pranavs41/tar-team1-hardware/electrical/docs/datasheets.md

# Datasheets and references

Links rather than PDFs, so the repo stays small and we always get the current revision. LCSC pages link the datasheet PDF.

## Espressif
- [ESP32-S3 Hardware Design Guidelines](https://docs.espressif.com/projects/esp-hardware-design-guidelines/en/latest/esp32s3/) is the schematic checklist for everything around the chip
- [ESP32-S3-MINI-1/1U datasheet](https://documentation.espressif.com/esp32-s3-mini-1_mini-1u_datasheet_en.pdf) has Figure 8-2 (p. 40) is the reference schematic we follow for the bare chip, crystal and RF

## Parts (LCSC)
| Part | Link |
|---|---|
| ESP32-S3FN8 | https://www.lcsc.com/product-detail/C2913196.html |
| 40 MHz crystal Q22FA12800101 | https://www.lcsc.com/product-detail/C255898.html |
| ICM-42688-P | https://www.lcsc.com/product-detail/C1850418.html |
| BMP581 | https://www.lcsc.com/product-detail/C5362283.html |
| MAX-M10S | https://www.lcsc.com/product-detail/C4153167.html |
| AP63205WU-7 | https://www.lcsc.com/product-detail/C2071056.html |
| TLV75733PDBVR | https://www.lcsc.com/product-detail/C485517.html |
| TPS7A2033PDBVR | https://www.lcsc.com/product-detail/C2862740.html |
| USBLC6-2SC6 | https://www.lcsc.com/product-detail/C7519.html |
| USB-C 16-pin | https://www.lcsc.com/product-detail/C2765186.html |
| LQG15HS2N0B02D (2.0 nH) | https://www.lcsc.com/product-detail/C2986275.html |

## Still to add
- u-blox MAX-M10S Integration Manual (RF input section)
