pranavs41/tar-team1-hardware/cad/board-bottom.png

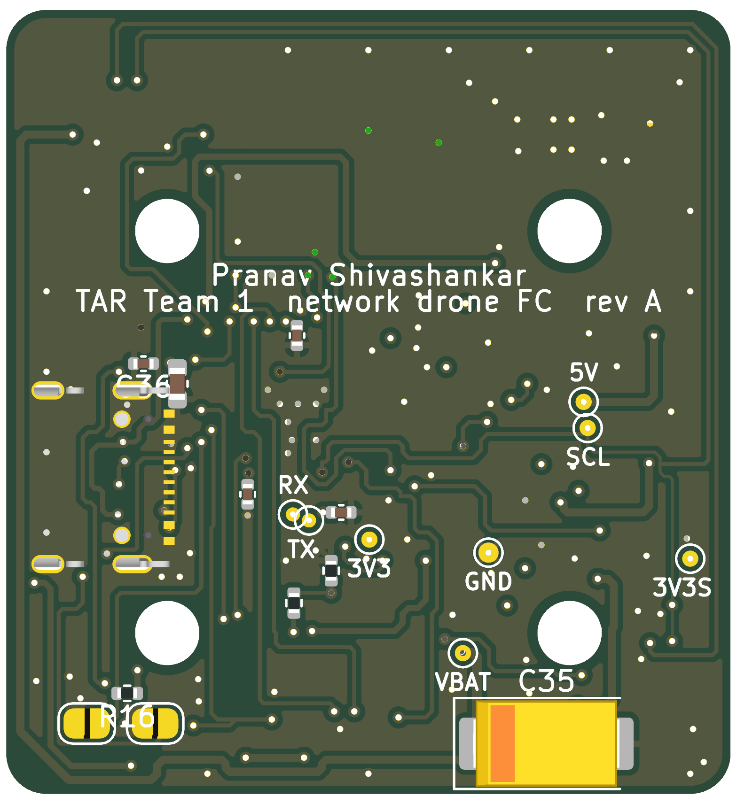
cad/board-bottom.png
