pranavs41/tar-team1-hardware/electrical/pcb/network-drone-fc/placement-top.png

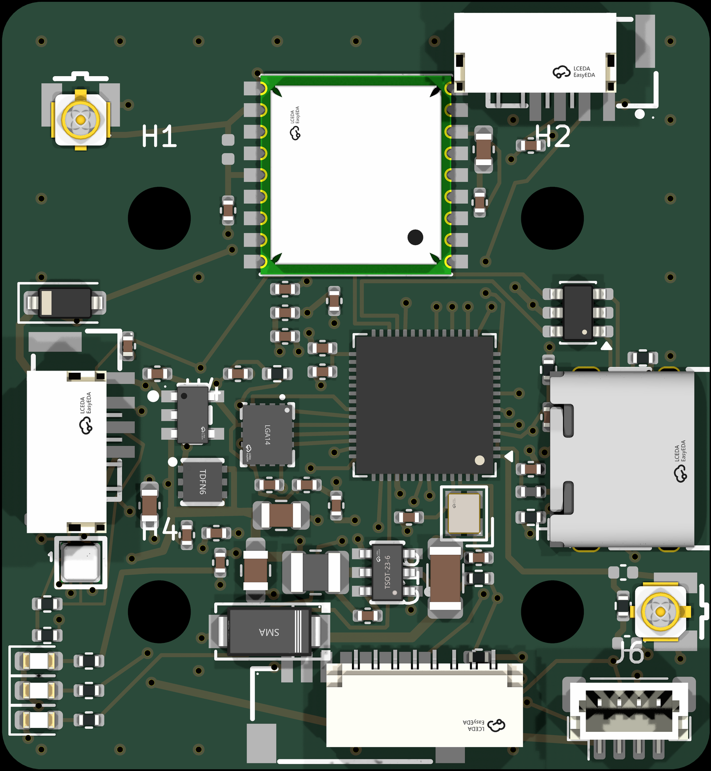
electrical/pcb/network-drone-fc/placement-top.png
