pranavs41/tar-team1-hardware/docs/full-order-sheet.csv

Group | Seller | Qty | Part | What it is | Link | Each USD | Line total USD | Note
Flight controller parts (1 board) | DigiKey | 1 | ESP32-S3FN8 | ESP32-S3 processor | https://www.digikey.com/en/products/detail/espressif-systems/ESP32-S3FN8/15822446 | 4.17 | 4.17
Flight controller parts (1 board) | DigiKey | 1 | MAX-M10S-00B | GPS module | https://www.digikey.com/en/products/detail/u-blox/MAX-M10S-00B/15712906 | 11.42 | 11.42
Flight controller parts (1 board) | Newark | 1 | ICM-42688-P | Gyro and accelerometer | https://www.newark.com/invensense/icm-42688-p/mems-module-x-y-z-1-71v/dp/77AH4524 | 4.86 | 4.86 | Buy from Newark. DigiKey has none. Take the price from Newark's page
Flight controller parts (1 board) | DigiKey | 1 | BMP581 | Barometer | https://www.digikey.com/en/products/detail/bosch-sensortec/BMP581/16036134 | 3.35 | 3.35 | Out of stock everywhere on 2026-10-13. DigiKey restock due 2026-11-04. Backorder it there or wait
Flight controller parts (1 board) | Mouser | 1 | AP63205WU-7 | 5 V buck regulator | https://www.mouser.com/ProductDetail/Diodes-Incorporated/AP63205WU-7 | 0.89 | 0.89 | Buy from Mouser, DigiKey has none. Take the price from Mouser's page
Flight controller parts (1 board) | DigiKey | 1 | TLV75733PDRVR | 3.3 V regulator, 1 A | https://www.digikey.com/en/products/detail/texas-instruments/TLV75733PDRVR/8038260 | 0.48 | 0.48
Flight controller parts (1 board) | Texas Instruments | 1 | TPS7A2033PDBVR | 3.3 V low-noise regulator | https://www.ti.com/product/TPS7A20/part-details/TPS7A2033PDBVR | 0.35 | 0.35 | Buy direct from ti.com. Not the TPS7A0233, which is a different, noisier part
Flight controller parts (1 board) | DigiKey | 1 | USBLC6-2SC6 | USB protection | https://www.digikey.com/en/products/detail/stmicroelectronics/USBLC6-2SC6/1040559 | 0.54 | 0.54
Flight controller parts (1 board) | DigiKey | 1 | FA-128 40.0000MF10Z-K3 | 40 MHz crystal, 10 pF, ±10 ppm | https://www.digikey.com/en/products/detail/epson/FA-128-40-0000MF10Z-K3/2514630 | 1.11 | 1.11
Flight controller parts (1 board) | DigiKey | 1 | TCJD107M025R0055 | 100 µF 25 V polymer capacitor | https://www.digikey.com/en/products/detail/avx-corporation/TCJD107M025R0055/4990375 | 3.65 | 3.65
Flight controller parts (1 board) | DigiKey | 1 | SMAJ12A | Battery surge diode, 12 V standoff | https://www.digikey.com/en/products/result?keywords=SMAJ12A | 0.51 | 0.51 | Was SMAJ18A: its surge clamp (up to 29 V) exceeded the 25 V capacitors and 20 V inductor on the battery line. The board is 2S only
Flight controller parts (1 board) | DigiKey | 1 | 1N5819HW-7-F | Schottky diode, 1 A 40 V, SOD-123 | https://www.digikey.com/en/products/detail/diodes-incorporated/1N5819HW-7-F/814970 | 0.31 | 0.31
Flight controller parts (1 board) | DigiKey | 3 | 150060RS75000 | LED 0603, red | https://www.digikey.com/en/products/result?keywords=150060RS75000 | 0.15 | 0.45
Flight controller parts (1 board) | DigiKey | 3 | 150060VS75000 | LED 0603, yellow-green | https://www.digikey.com/en/products/result?keywords=150060VS75000 | 0.15 | 0.45
Flight controller parts (1 board) | DigiKey | 3 | 150060YS75000 | LED 0603, yellow | https://www.digikey.com/en/products/result?keywords=150060YS75000 | 0.15 | 0.45
Flight controller parts (1 board) | DigiKey | 1 | SM08B-SRSS-TB | ESC connector, JST-SH 8-pin | https://www.digikey.com/en/products/detail/jst-sales-america-inc/SM08B-SRSS-TB-LF-SN/926714 | 0.85 | 0.85 | DigiKey lists it as SM08B-SRSS-TB(LF)(SN)
Flight controller parts (1 board) | LCSC | 1 | SM04B-GHS-TB | Obstacle sensor port, JST-GH 4-pin | https://www.lcsc.com/product-detail/Wire-To-Board-Connector_JST-SM04B-GHS-TB-LF-SN_C189895.html | 0.39 | 0.39 | LCSC ships from China. Or wait for DigiKey, restock due 2026-11-16
Flight controller parts (1 board) | DigiKey | 1 | SM07B-SRSS-TB | Charging port, JST-SH 7-pin | https://www.digikey.com/en/products/result?keywords=SM07B-SRSS-TB | 0.80 | 0.80 | DigiKey lists it as SM07B-SRSS-TB(LF)(SN)
Flight controller parts (1 board) | DigiKey | 2 | BM04B-SRSS-TB | Radio port and landing sensor port, JST-SH 4-pin top entry | https://www.digikey.com/en/products/detail/jst-sales-america-inc/BM04B-SRSS-TB/926696 | 0.53 | 1.06 | DigiKey lists it as BM04B-SRSS-TB(LF)(SN)
Flight controller parts (1 board) | DigiKey | 2 | U.FL-R-SMT-1(10) | Antenna sockets, U.FL | https://www.digikey.com/en/products/detail/hirose-electric-co-ltd/U-FL-R-SMT-1-10/2391570 | 1.67 | 3.34
Flight controller parts (1 board) | DigiKey | 1 | USB4105-GF-A | USB-C socket, 16-pin | https://www.digikey.com/en/products/detail/gct/USB4105-GF-A/11198441 | 0.80 | 0.80
Flight controller parts (1 board) | DigiKey | 1 | CIGW252010EH4R7MNE | Buck inductor, 4.7 µH, 2.2 A saturation | https://www.digikey.com/en/products/result?keywords=CIGW252010EH4R7MNE | 0.29 | 0.29
Flight controller parts (1 board) | DigiKey | 10 | LQG15HS2N0B02D | Radio supply inductor, 2.0 nH | https://www.digikey.com/en/products/result?keywords=LQG15HS2N0B02D | 0.10 | 1.00
Flight controller parts (1 board) | DigiKey | 10 | LQW15AN24NG00D | Crystal line inductor, 24 nH | https://www.digikey.com/en/products/result?keywords=LQW15AN24NG00D | 0.12 | 1.20
Flight controller parts (1 board) | DigiKey | 20 | GRM155R71C104KA88J | 0.1 µF 16 V, 0402 | https://www.digikey.com/en/products/result?keywords=GRM155R71C104KA88J | 0.10 | 2.00
Flight controller parts (1 board) | DigiKey | 10 | CL05A105KP5NNNC | 1 µF 10 V, 0402 | https://www.digikey.com/en/products/result?keywords=CL05A105KP5NNNC | 0.10 | 1.00
Flight controller parts (1 board) | DigiKey | 10 | GRM155R71H103KA88D | 10 nF 50 V, 0402 | https://www.digikey.com/en/products/result?keywords=GRM155R71H103KA88D | 0.10 | 1.00
Flight controller parts (1 board) | DigiKey | 10 | GRM1555C1H150JA01D | 15 pF 50 V, 0402 | https://www.digikey.com/en/products/result?keywords=GRM1555C1H150JA01D | 0.10 | 1.00
Flight controller parts (1 board) | DigiKey | 10 | GRM155R61C225KE11J | 2.2 µF 16 V, 0402 | https://www.digikey.com/en/products/result?keywords=GRM155R61C225KE11J | 0.22 | 2.20
Flight controller parts (1 board) | DigiKey | 10 | GRM188R60J106ME47D | 10 µF 6.3 V, 0603 | https://www.digikey.com/en/products/result?keywords=GRM188R60J106ME47D | 0.12 | 1.20
Flight controller parts (1 board) | DigiKey | 10 | GRM21BR61C226ME44L | 22 uF 16 V, 0805 | https://www.digikey.com/en/products/result?keywords=GRM21BR61C226ME44L | 0.45 | 4.50 | 16 V part keeps more of its capacitance at 5 V than the 10 V one did
Flight controller parts (1 board) | DigiKey | 1 | C2012X5R1E106K125AB | 10 µF 25 V, 0805 | https://www.digikey.com/en/products/result?keywords=C2012X5R1E106K125AB | 0.34 | 0.34 | Was the 1206 GRM319R61E106KA12D. The smaller size leaves room for the battery to reach the regulator beside it
Flight controller parts (1 board) | DigiKey | 10 | RC0402FR-0710KL | 10 kΩ 1%, 0402 | https://www.digikey.com/en/products/result?keywords=RC0402FR-0710KL | 0.10 | 1.00
Flight controller parts (1 board) | DigiKey | 10 | RC0402FR-075K1L | 5.1 kΩ 1%, 0402 | https://www.digikey.com/en/products/result?keywords=RC0402FR-075K1L | 0.10 | 1.00
Flight controller parts (1 board) | DigiKey | 10 | RC0402FR-071KL | 1 kΩ 1%, 0402 | https://www.digikey.com/en/products/result?keywords=RC0402FR-071KL | 0.10 | 1.00
Flight controller parts (1 board) | DigiKey | 10 | RC0402FR-072K2L | 2.2 kΩ 1%, 0402 | https://www.digikey.com/en/products/result?keywords=RC0402FR-072K2L | 0.10 | 1.00
Flight controller parts (1 board) | DigiKey | 10 | RC0402FR-07470RL | 470 Ω 1%, 0402 | https://www.digikey.com/en/products/detail/yageo/RC0402FR-07470RL/726619 | 0.10 | 1.00
Flight controller parts (1 board) | DigiKey | 10 | RC0402FR-07100KL | 100 kΩ 1%, 0402 | https://www.digikey.com/en/products/result?keywords=RC0402FR-07100KL | 0.10 | 1.00
Flight controller parts (1 board) | DigiKey | 10 | RC0402FR-07143KL | 143 kΩ 1%, 0402 | https://www.digikey.com/en/products/result?keywords=RC0402FR-07143KL | 0.10 | 1.00
Flight controller parts (1 board) | DigiKey | 10 | RC0402FR-0734KL | 34 kΩ 1%, 0402 | https://www.digikey.com/en/products/result?keywords=RC0402FR-0734KL | 0.10 | 1.00
Flight controller parts (1 board) | DigiKey | 10 | RC0402JR-070RL | 0 Ω link, 0402 | https://www.digikey.com/en/products/result?keywords=RC0402JR-070RL | 0.10 | 1.00
Drone parts (1 drone) | Pyrodrone | 4 | RCINPower GTS V3 1303 8000KV Plus (teal/pink) | Motor | https://pyrodrone.com/products/rcinpower-gts-v3-1303-8000kv-plus-2-3-inch-cinewhoop-micro-motor-teal-pink | 20.99 | 83.96 | Teal/pink, in stock 2026-10-15. The gold/orange colour is sold out; same motor. A fifth as a spare is worth considering
Drone parts (1 drone) | Amazon | 1 | AERO SELFIE 30 A 4-in-1 ESC | ESC, 2 to 4S, 20 mm holes, comes with its 8-pin cable | https://www.amazon.com/dp/B0DQSLQH87 | 28.90 | 28.90
Drone parts (1 drone) | Amazon | 2 | Benewake TF-Luna | Distance sensor, one forward and one down | https://www.amazon.com/dp/B0DKCSF8C5 | 25.99 | 51.98
Drone parts (1 drone) | RaceDayQuads | 1 | Gemfan Hurricane 3018, pack of 8 | Propellers, 1.5 mm hole, 4 clockwise and 4 counter-clockwise | https://www.racedayquads.com/products/gemfan-hurricane-3018-durable-bi-blade-3-prop-8-pack-1-5mm-choose-your-color | 4.99 | 4.99 | Pick a colour that shows in stock
Drone parts (1 drone) | VoCore | 1 | VoCore2 | Wi-Fi networking module | https://vocore.io/#store | 21.48 | 21.48 | Bought from the store section of the maker's front page. Ships from China. Confirm the price in the cart
Drone parts (1 drone) | DigiKey | 1 | FXP73.07.0100A | 2.4 GHz Wi-Fi antenna, U.FL plug | https://www.digikey.com/en/products/detail/taoglas-limited/FXP73-07-0100A/2332703 | 5.41 | 5.41
Drone parts (1 drone) | DigiKey | 1 | 2065600100 | GPS antenna, U.FL plug | https://www.digikey.com/en/products/result?keywords=2065600100 | 4.16 | 4.16
Drone parts (1 drone) | DigiKey | 1 | EEU-FR1V471 | 470 uF 35 V capacitor for the ESC's battery pads | https://www.digikey.com/en/products/detail/panasonic-industry/EEU-FR1V471/2433575 | 1.08 | 1.08 | Out of stock 2026-10-11, due 2026-11-09. Any 470 uF 35 V low-ESR radial capacitor works
Drone parts (1 drone) | DigiKey | 1 | GHR-04V-S | Plug housing for the forward sensor cable, JST-GH 4-pin | https://www.digikey.com/en/products/detail/jst-sales-america-inc/GHR-04V-S/807816 | 0.20 | 0.20 | Price approximate
Drone parts (1 drone) | DigiKey | 2 | AGHGH28K152 | Pre-crimped JST-GH wire, 150 mm | https://www.digikey.com/en/products/detail/jst-sales-america-inc/AGHGH28K152/6009449 | 0.49 | 0.98 | Price approximate. If the link fails, search the part number
Drone parts (1 drone) | Adafruit | 1 | Adafruit LIS3MDL magnetometer breakout (product 4479) | Compass, 1.5 g | https://www.adafruit.com/product/4479 | 9.95 | 9.95 | Shares the I2C wires of the J5 or J8 cable. Runs from that cable's 5 V. Mount it away from the battery leads and ESC
Drone parts (1 drone) | Pololu | 2 | Pololu 5521 | JST-SH 4-pin cable, bare wires on one end, 30 cm | https://www.pololu.com/product/5521 | 2.04 | 4.08 | One for the downward sensor, one for the VoCore2
Drone parts (1 drone) | Amazon | 1 | M2 nylon standoff, screw and nut kit, 180 pieces (HVAZI or similar) | Hardware for the flight controller and ESC stack | https://www.amazon.com/s?k=HVAZI+M2+nylon+standoff+screw+nut+kit+180 | 9.99 | 9.99 | M2, not M3: an M3 nut would not sit flat on top of the board at three holes. M2 passes through the M3 holes. Link is a search; pick a black M2 nylon kit with standoffs, screws and nuts. One kit covers several drones
Drone parts (1 drone) | RaceDayQuads | 1 | XT30 connector | Battery connector, male | https://www.racedayquads.com/products/xt30-connector-male-or-female | 0.99 | 0.99 | Male, for the ESC's battery lead. The battery comes with its own XT30
Drone parts (1 drone) | Amazon | 1 | OVONIC 2S 1100 mAh 7.6 V 60C battery, pack of 2 | Battery | https://www.amazon.com/dp/B0D318NL5W | 26.99 | 26.99 | Pack of 2, $13.50 a battery. High-voltage type (charge to 4.35 V a cell), XT30 plug, 60C. Price read 2026-10-15
Charging board parts (1 board) | DigiKey | 1 | BQ25887RGER | 2S boost charger with cell balancing, 4 x 4 mm QFN | https://www.digikey.com/en/products/result?keywords=BQ25887RGER | 5.61 | 5.61 | Texas Instruments. DigiKey had about 11 thousand on 2026-10-15; TI's own store was out
Charging board parts (1 board) | DigiKey | 1 | TPS259474LRPWR | eFuse with overvoltage cut-off and reverse blocking, 2.7 to 23 V, 2 x 2 mm QFN | https://www.digikey.com/en/products/result?keywords=TPS259474LRPWR | 1.95 | 1.95 | Texas Instruments. Replaces the LM73100, out of stock until December. Same footprint and same pins 1 to 8. Rated to 28 V, survives -15 V (a reversed dock), blocks the battery from the dock contacts, cuts off above the voltage set by its two resistors. Pin 9 needs a current limit resistor
Charging board parts (1 board) | DigiKey | 10 | RC0603FR-07470KL | 470 kohm 1% resistor, 0603 (enable pull-up) | https://www.digikey.com/en/products/result?keywords=RC0603FR-07470KL | 0.03 | 0.30 | Yageo. From IN to EN/UVLO. The datasheet asks for at least 350 kohm above 5 V or where the input can be reversed
Charging board parts (1 board) | DigiKey | 10 | RC0603FR-07402KL | 402 kohm 1% resistor, 0603 (overvoltage cut-off, top) | https://www.digikey.com/en/products/result?keywords=RC0603FR-07402KL | 0.03 | 0.30 | Yageo. With 100 kohm below it, cuts the charger off above about 6.0 V. Ten times the old 40.2 kohm so a reversed dock pulls little current out of the pin
Charging board parts (1 board) | DigiKey | 10 | RMCF0603FT100K | 100 kohm 1% resistor, 0603 (overvoltage cut-off, bottom) | https://www.digikey.com/en/products/result?keywords=RMCF0603FT100K | 0.02 | 0.20 | Stackpole. The Yageo and Panasonic 100 kohm are out of stock
Charging board parts (1 board) | DigiKey | 1 | DFE252012F-1R0M=P2 | Power inductor 1 uH, shielded | https://www.digikey.com/en/products/result?keywords=DFE252012F-1R0M%3DP2 | 0.25 | 0.25 | Murata. Saturation 4.7 A. The inductor TI's datasheet uses. Peak current here is about 1.6 A (0.925 A input plus half of a 1.35 A ripple)
Charging board parts (1 board) | DigiKey | 1 | SMBJ5.0A | 5 V surge diode on the dock input | https://www.digikey.com/en/products/detail/littelfuse-inc/SMBJ5-0A/285950 | 0.50 | 0.50 | Littelfuse. The Diodes Incorporated SMBJ5.0A-13-F is out of stock until January; same ratings. Clamps near 9 V, which the eFuse (28 V) and the charger's input (20 V) both survive
Charging board parts (1 board) | DigiKey | 1 | 1206L110THYR | Resettable fuse, about 1 A hold, 1206 | https://www.digikey.com/en/products/result?keywords=1206L110THYR | 0.65 | 0.65 | Littelfuse. Checked 2026-10-15: 1.1 A hold, 2.2 A trip, 8 V max
Charging board parts (1 board) | DigiKey | 10 | RC0603FR-071K2L | 1.2 kohm 1% resistor, 0603 (input current limit) | https://www.digikey.com/en/products/result?keywords=RC0603FR-071K2L | 0.10 | 1.00 | Yageo. Input limit = 1110 / 1200 ohm = 0.925 A typical (datasheet K_ILIM 1110)
Charging board parts (1 board) | DigiKey | 10 | ERJ-3EKF2211V | 2.21 kohm 1% resistor, 0603 (eFuse current limit) | https://www.digikey.com/en/products/result?keywords=ERJ-3EKF2211V | 0.04 | 0.40 | Panasonic. From the eFuse's ILM pin (9) to GND. Trips at 3334 / 2210 = about 1.5 A, above the charger's 0.925 A input limit. Must not be left open or shorted to GND
Charging board parts (1 board) | DigiKey | 10 | RC0603FR-07300RL | 300 ohm 1% resistor, 0603 (cell balancing midpoint) | https://www.digikey.com/en/products/result?keywords=RC0603FR-07300RL | 0.10 | 1.00 | Yageo. 0603 assumed
Charging board parts (1 board) | DigiKey | 10 | RC0603FR-075K23L | 5.23 kohm 1% resistor, 0603 (thermistor bias, top) | https://www.digikey.com/en/products/result?keywords=RC0603FR-075K23L | 0.10 | 1.00 | Yageo. Datasheet value for a 103AT thermistor is 5.24 kohm; 5.23 kohm is the nearest 1% value
Charging board parts (1 board) | DigiKey | 10 | RC0603FR-0730K1L | 30.1 kohm 1% resistor, 0603 (thermistor bias, bottom) | https://www.digikey.com/en/products/result?keywords=RC0603FR-0730K1L | 0.10 | 1.00 | Yageo. Datasheet value is 30.31 kohm; 30.1 kohm is the nearest 1% value
Charging board parts (1 board) | DigiKey | 2 | RC2512FK-0740R2L | 40.2 ohm 1% resistor, 1 W, 2512 (balancing current set) | https://www.digikey.com/en/products/result?keywords=RC2512FK-0740R2L | 0.32 | 0.64 | Yageo. Every 41.2 ohm 1 W 2512 is out of stock. Sets about 104 mA of balancing current (4.2 V / 40.2 ohm) and dissipates about 0.44 W, inside the 1 W rating
Charging board parts (1 board) | DigiKey | 1 | 103AT-2 | 10 kohm battery thermistor | https://www.digikey.com/en/products/result?keywords=103AT-2 | 0.68 | 0.68 | Semitec. Must touch the battery
Charging board parts (1 board) | DigiKey | 10 | C1608X7R1E105K080AB | 1 uF 25 V X7R capacitor, 0603 (VBUS) | https://www.digikey.com/en/products/result?keywords=C1608X7R1E105K080AB | 0.11 | 1.10 | TDK. The Murata GRM188R71E105KA12D is obsolete. Datasheet: at least 1 uF at VBUS, 25 V rating preferred for a 5 V input
Charging board parts (1 board) | DigiKey | 10 | C2012X5R1E106K125AB | 10 uF 25 V capacitor, 0805 (PMID and BAT) | https://www.digikey.com/en/products/result?keywords=C2012X5R1E106K125AB | 0.34 | 3.40 | TDK, X5R. Was the Murata GRM21BR61E106KA73L, out of stock until November; this is the same part as the flight controller's C16. Datasheet: 10 uF at PMID with a 25 V rating; the same part works at BAT
Charging board parts (1 board) | DigiKey | 10 | C0603C473K5RACTU | 47 nF 50 V X7R capacitor, 0603 (bootstrap) | https://www.digikey.com/en/products/result?keywords=C0603C473K5RACTU | 0.07 | 0.70 | KEMET. The Murata GRM188R71H473KA61D is obsolete
Charging board parts (1 board) | DigiKey | 10 | C1608X5R1C475K080AC | 4.7 uF 16 V X5R capacitor, 0603 (REGN) | https://www.digikey.com/en/products/result?keywords=C1608X5R1C475K080AC | 0.15 | 1.50 | TDK. DigiKey does not stock the Murata GRM188R61C475KAAJD
Charging board parts (1 board) | DigiKey | 4 | C2012X5R1C226M085AC | 22 uF 16 V X5R capacitor, 0805 (output) | https://www.digikey.com/en/products/result?keywords=C2012X5R1C226M085AC | 0.63 | 2.52 | TDK, 0.85 mm thick. The Murata GRM21BR61C226ME44L is out of stock until February. Datasheet: at least 44 uF at SNS, 16 V or more, so two per board; check the derated value at 8.4 V
Charging board parts (1 board) | DigiKey | 1 | SM07B-SRSS-TB | 7-pin JST-SH connector to the flight controller | https://www.digikey.com/en/products/result?keywords=SM07B-SRSS-TB | 0.80 | 0.80 | JST. Same part as J7 on the flight controller
Charging board parts (1 board) | DigiKey | 1 | B3B-XH-A | 3-pin JST-XH header for the battery's balance plug | https://www.digikey.com/en/products/result?keywords=B3B-XH-A | 0.15 | 0.15 | JST
Charging board parts (1 board) | DigiKey | 2 | SHR-07V-S-B | 7-pin JST-SH plug housing, both ends of the cable to the flight controller | https://www.digikey.com/en/products/detail/jst-sales-america-inc/SHR-07V-S-B/759871 | 0.15 | 0.30 | JST
Charging board parts (1 board) | DigiKey | 7 | ASSHSSH28K152 | Pre-crimped JST-SH wire, 150 mm, one per cable pin | https://www.digikey.com/en/products/detail/jst-sales-america-inc/ASSHSSH28K152/6009452 | 0.46 | 3.22 | JST. Push one end of each wire into each housing, pin 1 to pin 1
 |  |  |  | Drone parts |  |  | 255.14
 |  |  |  | Flight controller parts |  |  | 64.96
 |  |  |  | Charging board parts |  |  | 29.17
 |  |  |  | Total before shipping and tax |  |  | 349.27
