pranavs41/tar-team1-hardware/docs/vendor-orders/adafruit.xlsx

Item | Quantity | Cost per Item | Total Cost | Item/SKU Number | Other Specs if Applicable | Link | Total
Adafruit LIS3MDL magnetometer breakout (product 4479) | 1 | $9.95 |  | Adafruit LIS3MDL magnetometer breakout (product 4479) | Drone; Compass, 1.5 g; Shares the I2C wires of the J5 or J8 cable. Runs from that cable's 5 V. | https://www.adafruit.com/product/4479
 |  |  |  |  |  | Please select fastest shipping available | $0.00
 |  |  |  |  |  | Grand Total
