pranavs41/tar-team1-hardware/docs/vendor-orders/all-vendors.xlsx

Sheet: DigiKey
Item | Quantity | Cost per Item | Total Cost | Item/SKU Number | Other Specs if Applicable | Link | Total
ESP32-S3 processor | 1 | $4.17 |  | ESP32-S3FN8 | Flight controller | https://www.digikey.com/en/products/detail/espressif-systems/ESP32-S3FN8/15822446
GPS module | 1 | $11.42 |  | MAX-M10S-00B | Flight controller | https://www.digikey.com/en/products/detail/u-blox/MAX-M10S-00B/15712906
Barometer | 1 | $3.35 |  | BMP581 | Flight controller; Out of stock everywhere on 2026-10-13. DigiKey restock due 2026-11-04. | https://www.digikey.com/en/products/detail/bosch-sensortec/BMP581/16036134
3.3 V regulator, 1 A | 1 | $0.48 |  | TLV75733PDRVR | Flight controller | https://www.digikey.com/en/products/detail/texas-instruments/TLV75733PDRVR/8038260
USB protection | 1 | $0.54 |  | USBLC6-2SC6 | Flight controller | https://www.digikey.com/en/products/detail/stmicroelectronics/USBLC6-2SC6/1040559
40 MHz crystal, 10 pF, ±10 ppm | 1 | $1.11 |  | FA-128 40.0000MF10Z-K3 | Flight controller | https://www.digikey.com/en/products/detail/epson/FA-128-40-0000MF10Z-K3/2514630
100 µF 25 V polymer capacitor | 1 | $3.65 |  | TCJD107M025R0055 | Flight controller | https://www.digikey.com/en/products/detail/avx-corporation/TCJD107M025R0055/4990375
Battery surge diode, 12 V standoff | 1 | $0.51 |  | SMAJ12A | Flight controller; The board is 2S only | https://www.digikey.com/en/products/result?keywords=SMAJ12A
Schottky diode, 1 A 40 V, SOD-123 | 1 | $0.31 |  | 1N5819HW-7-F | Flight controller | https://www.digikey.com/en/products/detail/diodes-incorporated/1N5819HW-7-F/814970
LED 0603, red | 3 | $0.15 |  | 150060RS75000 | Flight controller | https://www.digikey.com/en/products/result?keywords=150060RS75000
LED 0603, yellow-green | 3 | $0.15 |  | 150060VS75000 | Flight controller | https://www.digikey.com/en/products/result?keywords=150060VS75000
LED 0603, yellow | 3 | $0.15 |  | 150060YS75000 | Flight controller | https://www.digikey.com/en/products/result?keywords=150060YS75000
ESC connector, JST-SH 8-pin | 1 | $0.85 |  | SM08B-SRSS-TB | Flight controller; DigiKey lists it as SM08B-SRSS-TB(LF)(SN) | https://www.digikey.com/en/products/detail/jst-sales-america-inc/SM08B-SRSS-TB-LF-SN/926714
Charging port, JST-SH 7-pin | 1 | $0.80 |  | SM07B-SRSS-TB | Flight controller; DigiKey lists it as SM07B-SRSS-TB(LF)(SN) | https://www.digikey.com/en/products/result?keywords=SM07B-SRSS-TB
Radio port and landing sensor port, JST-SH 4-pin top entry | 2 | $0.53 |  | BM04B-SRSS-TB | Flight controller; DigiKey lists it as BM04B-SRSS-TB(LF)(SN) | https://www.digikey.com/en/products/detail/jst-sales-america-inc/BM04B-SRSS-TB/926696
Antenna sockets, U.FL | 2 | $1.67 |  | U.FL-R-SMT-1(10) | Flight controller | https://www.digikey.com/en/products/detail/hirose-electric-co-ltd/U-FL-R-SMT-1-10/2391570
USB-C socket, 16-pin | 1 | $0.80 |  | USB4105-GF-A | Flight controller | https://www.digikey.com/en/products/detail/gct/USB4105-GF-A/11198441
Buck inductor, 4.7 µH, 2.2 A saturation | 1 | $0.29 |  | CIGW252010EH4R7MNE | Flight controller | https://www.digikey.com/en/products/result?keywords=CIGW252010EH4R7MNE
Radio supply inductor, 2.0 nH | 10 | $0.10 |  | LQG15HS2N0B02D | Flight controller | https://www.digikey.com/en/products/result?keywords=LQG15HS2N0B02D
Crystal line inductor, 24 nH | 10 | $0.12 |  | LQW15AN24NG00D | Flight controller | https://www.digikey.com/en/products/result?keywords=LQW15AN24NG00D
0.1 µF 16 V, 0402 | 20 | $0.10 |  | GRM155R71C104KA88J | Flight controller | https://www.digikey.com/en/products/result?keywords=GRM155R71C104KA88J
1 µF 10 V, 0402 | 10 | $0.10 |  | CL05A105KP5NNNC | Flight controller | https://www.digikey.com/en/products/result?keywords=CL05A105KP5NNNC
10 nF 50 V, 0402 | 10 | $0.10 |  | GRM155R71H103KA88D | Flight controller | https://www.digikey.com/en/products/result?keywords=GRM155R71H103KA88D
15 pF 50 V, 0402 | 10 | $0.10 |  | GRM1555C1H150JA01D | Flight controller | https://www.digikey.com/en/products/result?keywords=GRM1555C1H150JA01D
2.2 µF 16 V, 0402 | 10 | $0.22 |  | GRM155R61C225KE11J | Flight controller | https://www.digikey.com/en/products/result?keywords=GRM155R61C225KE11J
10 µF 6.3 V, 0603 | 10 | $0.12 |  | GRM188R60J106ME47D | Flight controller | https://www.digikey.com/en/products/result?keywords=GRM188R60J106ME47D
22 uF 16 V, 0805 | 10 | $0.45 |  | GRM21BR61C226ME44L | Flight controller; 16 V part keeps more of its capacitance at 5 V than the 10 V one did | https://www.digikey.com/en/products/result?keywords=GRM21BR61C226ME44L
10 µF 25 V, 0805 | 1 | $0.34 |  | C2012X5R1E106K125AB | Flight controller; The smaller size leaves room for the battery to reach the regulator beside it | https://www.digikey.com/en/products/result?keywords=C2012X5R1E106K125AB
10 kΩ 1%, 0402 | 10 | $0.10 |  | RC0402FR-0710KL | Flight controller | https://www.digikey.com/en/products/result?keywords=RC0402FR-0710KL
5.1 kΩ 1%, 0402 | 10 | $0.10 |  | RC0402FR-075K1L | Flight controller | https://www.digikey.com/en/products/result?keywords=RC0402FR-075K1L
1 kΩ 1%, 0402 | 10 | $0.10 |  | RC0402FR-071KL | Flight controller | https://www.digikey.com/en/products/result?keywords=RC0402FR-071KL
2.2 kΩ 1%, 0402 | 10 | $0.10 |  | RC0402FR-072K2L | Flight controller | https://www.digikey.com/en/products/result?keywords=RC0402FR-072K2L
470 Ω 1%, 0402 | 10 | $0.10 |  | RC0402FR-07470RL | Flight controller | https://www.digikey.com/en/products/detail/yageo/RC0402FR-07470RL/726619
100 kΩ 1%, 0402 | 10 | $0.10 |  | RC0402FR-07100KL | Flight controller | https://www.digikey.com/en/products/result?keywords=RC0402FR-07100KL
143 kΩ 1%, 0402 | 10 | $0.10 |  | RC0402FR-07143KL | Flight controller | https://www.digikey.com/en/products/result?keywords=RC0402FR-07143KL
34 kΩ 1%, 0402 | 10 | $0.10 |  | RC0402FR-0734KL | Flight controller | https://www.digikey.com/en/products/result?keywords=RC0402FR-0734KL
0 Ω link, 0402 | 10 | $0.10 |  | RC0402JR-070RL | Flight controller | https://www.digikey.com/en/products/result?keywords=RC0402JR-070RL
FXP73.07.0100A | 1 | $5.41 |  | FXP73.07.0100A | Drone; 2.4 GHz Wi-Fi antenna, U.FL plug | https://www.digikey.com/en/products/detail/taoglas-limited/FXP73-07-0100A/2332703
2065600100 | 1 | $4.16 |  | 2065600100 | Drone; GPS antenna, U.FL plug | https://www.digikey.com/en/products/result?keywords=2065600100
EEU-FR1V471 | 1 | $1.08 |  | EEU-FR1V471 | Drone; 470 uF 35 V capacitor for the ESC's battery pads; Out of stock 2026-10-11, due 2026-11-09. Any 470 uF 35 V low-ESR radial capacitor works | https://www.digikey.com/en/products/detail/panasonic-industry/EEU-FR1V471/2433575
GHR-04V-S | 1 | $0.20 |  | GHR-04V-S | Drone; Plug housing for the forward sensor cable, JST-GH 4-pin; Price approximate | https://www.digikey.com/en/products/detail/jst-sales-america-inc/GHR-04V-S/807816
AGHGH28K152 | 2 | $0.49 |  | AGHGH28K152 | Drone; Pre-crimped JST-GH wire, 150 mm; Price approximate. If the link fails, search the part number | https://www.digikey.com/en/products/detail/jst-sales-america-inc/AGHGH28K152/6009449
2S boost charger with cell balancing, 4 x 4 mm QFN | 1 | $5.61 |  | BQ25887RGER | Charging board; Texas Instruments. DigiKey had about 11 thousand on 2026-10-15; TI's own store was out | https://www.digikey.com/en/products/result?keywords=BQ25887RGER
eFuse with overvoltage cut-off and reverse blocking, 2.7 to 23 V, 2 x 2 mm QFN | 1 | $1.95 |  | TPS259474LRPWR | Charging board; Texas Instruments. Replaces the LM73100, out of stock until December. | https://www.digikey.com/en/products/result?keywords=TPS259474LRPWR
470 kohm 1% resistor, 0603 (enable pull-up) | 10 | $0.03 |  | RC0603FR-07470KL | Charging board; Yageo. From IN to EN/UVLO. | https://www.digikey.com/en/products/result?keywords=RC0603FR-07470KL
402 kohm 1% resistor, 0603 (overvoltage cut-off, top) | 10 | $0.03 |  | RC0603FR-07402KL | Charging board; Yageo. With 100 kohm below it, cuts the charger off above about 6.0 V. | https://www.digikey.com/en/products/result?keywords=RC0603FR-07402KL
100 kohm 1% resistor, 0603 (overvoltage cut-off, bottom) | 10 | $0.02 |  | RMCF0603FT100K | Charging board; Stackpole. The Yageo and Panasonic 100 kohm are out of stock | https://www.digikey.com/en/products/result?keywords=RMCF0603FT100K
Power inductor 1 uH, shielded | 1 | $0.25 |  | DFE252012F-1R0M=P2 | Charging board; Murata. Saturation 4.7 A. | https://www.digikey.com/en/products/result?keywords=DFE252012F-1R0M%3DP2
5 V surge diode on the dock input | 1 | $0.50 |  | SMBJ5.0A | Charging board; Littelfuse. The Diodes Incorporated SMBJ5.0A-13-F is out of stock until January; same ratings. | https://www.digikey.com/en/products/detail/littelfuse-inc/SMBJ5-0A/285950
Resettable fuse, about 1 A hold, 1206 | 1 | $0.65 |  | 1206L110THYR | Charging board; Littelfuse. Checked 2026-10-15: 1.1 A hold, 2.2 A trip, 8 V max | https://www.digikey.com/en/products/result?keywords=1206L110THYR
1.2 kohm 1% resistor, 0603 (input current limit) | 10 | $0.10 |  | RC0603FR-071K2L | Charging board; Yageo. Input limit = 1110 / 1200 ohm = 0.925 A typical (datasheet K_ILIM 1110) | https://www.digikey.com/en/products/result?keywords=RC0603FR-071K2L
2.21 kohm 1% resistor, 0603 (eFuse current limit) | 10 | $0.04 |  | ERJ-3EKF2211V | Charging board; Panasonic. From the eFuse's ILM pin (9) to GND. | https://www.digikey.com/en/products/result?keywords=ERJ-3EKF2211V
300 ohm 1% resistor, 0603 (cell balancing midpoint) | 10 | $0.10 |  | RC0603FR-07300RL | Charging board; Yageo. 0603 assumed | https://www.digikey.com/en/products/result?keywords=RC0603FR-07300RL
5.23 kohm 1% resistor, 0603 (thermistor bias, top) | 10 | $0.10 |  | RC0603FR-075K23L | Charging board; Yageo. Datasheet value for a 103AT thermistor is 5.24 kohm; 5.23 kohm is the nearest 1% value | https://www.digikey.com/en/products/result?keywords=RC0603FR-075K23L
30.1 kohm 1% resistor, 0603 (thermistor bias, bottom) | 10 | $0.10 |  | RC0603FR-0730K1L | Charging board; Yageo. Datasheet value is 30.31 kohm; 30.1 kohm is the nearest 1% value | https://www.digikey.com/en/products/result?keywords=RC0603FR-0730K1L
40.2 ohm 1% resistor, 1 W, 2512 (balancing current set) | 2 | $0.32 |  | RC2512FK-0740R2L | Charging board; Yageo. Every 41.2 ohm 1 W 2512 is out of stock. | https://www.digikey.com/en/products/result?keywords=RC2512FK-0740R2L
10 kohm battery thermistor | 1 | $0.68 |  | 103AT-2 | Charging board; Semitec. Must touch the battery | https://www.digikey.com/en/products/result?keywords=103AT-2
1 uF 25 V X7R capacitor, 0603 (VBUS) | 10 | $0.11 |  | C1608X7R1E105K080AB | Charging board; TDK. The Murata GRM188R71E105KA12D is obsolete. | https://www.digikey.com/en/products/result?keywords=C1608X7R1E105K080AB
10 uF 25 V capacitor, 0805 (PMID and BAT) | 10 | $0.34 |  | C2012X5R1E106K125AB | Charging board; TDK, X5R. Datasheet: 10 uF at PMID with a 25 V rating; the same part works at BAT | https://www.digikey.com/en/products/result?keywords=C2012X5R1E106K125AB
47 nF 50 V X7R capacitor, 0603 (bootstrap) | 10 | $0.07 |  | C0603C473K5RACTU | Charging board; KEMET. The Murata GRM188R71H473KA61D is obsolete | https://www.digikey.com/en/products/result?keywords=C0603C473K5RACTU
4.7 uF 16 V X5R capacitor, 0603 (REGN) | 10 | $0.15 |  | C1608X5R1C475K080AC | Charging board; TDK. DigiKey does not stock the Murata GRM188R61C475KAAJD | https://www.digikey.com/en/products/result?keywords=C1608X5R1C475K080AC
22 uF 16 V X5R capacitor, 0805 (output) | 4 | $0.63 |  | C2012X5R1C226M085AC | Charging board; TDK, 0.85 mm thick. The Murata GRM21BR61C226ME44L is out of stock until February. | https://www.digikey.com/en/products/result?keywords=C2012X5R1C226M085AC
7-pin JST-SH connector to the flight controller | 1 | $0.80 |  | SM07B-SRSS-TB | Charging board; JST. Same part as J7 on the flight controller | https://www.digikey.com/en/products/result?keywords=SM07B-SRSS-TB
3-pin JST-XH header for the battery's balance plug | 1 | $0.15 |  | B3B-XH-A | Charging board; JST | https://www.digikey.com/en/products/result?keywords=B3B-XH-A
7-pin JST-SH plug housing, both ends of the cable to the flight controller | 2 | $0.15 |  | SHR-07V-S-B | Charging board; JST | https://www.digikey.com/en/products/detail/jst-sales-america-inc/SHR-07V-S-B/759871
Pre-crimped JST-SH wire, 150 mm, one per cable pin | 7 | $0.46 |  | ASSHSSH28K152 | Charging board; JST. Push one end of each wire into each housing, pin 1 to pin 1 | https://www.digikey.com/en/products/detail/jst-sales-america-inc/ASSHSSH28K152/6009452
 |  |  |  |  |  | Please select fastest shipping available | $0.00
 |  |  |  |  |  | Grand Total

Sheet: Newark
Item | Quantity | Cost per Item | Total Cost | Item/SKU Number | Other Specs if Applicable | Link | Total
Gyro and accelerometer | 1 | $4.86 |  | ICM-42688-P | Flight controller; DigiKey has none. | https://www.newark.com/invensense/icm-42688-p/mems-module-x-y-z-1-71v/dp/77AH4524
 |  |  |  |  |  | Please select fastest shipping available | $0.00
 |  |  |  |  |  | Grand Total

Sheet: Mouser
Item | Quantity | Cost per Item | Total Cost | Item/SKU Number | Other Specs if Applicable | Link | Total
5 V buck regulator | 1 | $0.89 |  | AP63205WU-7 | Flight controller | https://www.mouser.com/ProductDetail/Diodes-Incorporated/AP63205WU-7
 |  |  |  |  |  | Please select fastest shipping available | $0.00
 |  |  |  |  |  | Grand Total

Sheet: Texas Instruments
Item | Quantity | Cost per Item | Total Cost | Item/SKU Number | Other Specs if Applicable | Link | Total
3.3 V low-noise regulator | 1 | $0.35 |  | TPS7A2033PDBVR | Flight controller; Not the TPS7A0233, which is a different, noisier part | https://www.ti.com/product/TPS7A20/part-details/TPS7A2033PDBVR
 |  |  |  |  |  | Please select fastest shipping available | $0.00
 |  |  |  |  |  | Grand Total

Sheet: LCSC
Item | Quantity | Cost per Item | Total Cost | Item/SKU Number | Other Specs if Applicable | Link | Total
Obstacle sensor port, JST-GH 4-pin | 1 | $0.39 |  | SM04B-GHS-TB | Flight controller; LCSC ships from China. Or wait for DigiKey, restock due 2026-11-16 | https://www.lcsc.com/product-detail/Wire-To-Board-Connector_JST-SM04B-GHS-TB-LF-SN_C189895.html
 |  |  |  |  |  | Please select fastest shipping available | $0.00
 |  |  |  |  |  | Grand Total

Sheet: Pyrodrone
Item | Quantity | Cost per Item | Total Cost | Item/SKU Number | Other Specs if Applicable | Link | Total
RCINPower GTS V3 1303 8000KV Plus (teal/pink) | 4 | $20.99 |  | RCINPower GTS V3 1303 8000KV Plus (teal/pink) | Drone; Motor; Teal/pink, in stock 2026-10-15. The gold/orange colour is sold out; same motor. | https://pyrodrone.com/products/rcinpower-gts-v3-1303-8000kv-plus-2-3-inch-cinewhoop-micro-motor-teal-pink
 |  |  |  |  |  | Please select fastest shipping available | $0.00
 |  |  |  |  |  | Grand Total

Sheet: Amazon
Item | Quantity | Cost per Item | Total Cost | Item/SKU Number | Other Specs if Applicable | Link | Total
AERO SELFIE 30 A 4-in-1 ESC | 1 | $28.90 |  | B0DQSLQH87 | Drone; ESC, 2 to 4S, 20 mm holes, comes with its 8-pin cable | https://www.amazon.com/dp/B0DQSLQH87
Benewake TF-Luna | 2 | $25.99 |  | B0DKCSF8C5 | Drone; Distance sensor, one forward and one down | https://www.amazon.com/dp/B0DKCSF8C5
M2 nylon standoff, screw and nut kit, 180 pieces (HVAZI or similar) | 1 | $9.99 |  |  | Drone; Hardware for the flight controller and ESC stack; M2, not M3: an M3 nut would not sit flat on top of the board at three holes. M2 passes through the M3 holes. | https://www.amazon.com/s?k=HVAZI+M2+nylon+standoff+screw+nut+kit+180
OVONIC 2S 1100 mAh 7.6 V 60C battery, pack of 2 | 1 | $26.99 |  | B0D318NL5W | Drone; Battery; Pack of 2, $13.50 a battery. High-voltage type (charge to 4.35 V a cell), XT30 plug, 60C. | https://www.amazon.com/dp/B0D318NL5W
 |  |  |  |  |  | Please select fastest shipping available | $0.00
 |  |  |  |  |  | Grand Total

Sheet: RaceDayQuads
Item | Quantity | Cost per Item | Total Cost | Item/SKU Number | Other Specs if Applicable | Link | Total
Gemfan Hurricane 3018, pack of 8 | 1 | $4.99 |  | Gemfan Hurricane 3018, pack of 8 | Drone; Propellers, 1.5 mm hole, 4 clockwise and 4 counter-clockwise; Pick a colour that shows in stock | https://www.racedayquads.com/products/gemfan-hurricane-3018-durable-bi-blade-3-prop-8-pack-1-5mm-choose-your-color
XT30 connector | 1 | $0.99 |  | XT30 connector | Drone; Battery connector, male; Male, for the ESC's battery lead. The battery comes with its own XT30 | https://www.racedayquads.com/products/xt30-connector-male-or-female
 |  |  |  |  |  | Please select fastest shipping available | $0.00
 |  |  |  |  |  | Grand Total

Sheet: VoCore
Item | Quantity | Cost per Item | Total Cost | Item/SKU Number | Other Specs if Applicable | Link | Total
VoCore2 | 1 | $21.48 |  | VoCore2 | Drone; Wi-Fi networking module; Bought from the store section of the maker's front page. Ships from China. | https://vocore.io/#store
 |  |  |  |  |  | Please select fastest shipping available | $0.00
 |  |  |  |  |  | Grand Total

Sheet: Adafruit
Item | Quantity | Cost per Item | Total Cost | Item/SKU Number | Other Specs if Applicable | Link | Total
Adafruit LIS3MDL magnetometer breakout (product 4479) | 1 | $9.95 |  | Adafruit LIS3MDL magnetometer breakout (product 4479) | Drone; Compass, 1.5 g; Shares the I2C wires of the J5 or J8 cable. Runs from that cable's 5 V. | https://www.adafruit.com/product/4479
 |  |  |  |  |  | Please select fastest shipping available | $0.00
 |  |  |  |  |  | Grand Total

Sheet: Pololu
Item | Quantity | Cost per Item | Total Cost | Item/SKU Number | Other Specs if Applicable | Link | Total
Pololu 5521 | 2 | $2.04 |  | Pololu 5521 | Drone; JST-SH 4-pin cable, bare wires on one end, 30 cm; One for the downward sensor, one for the VoCore2 | https://www.pololu.com/product/5521
 |  |  |  |  |  | Please select fastest shipping available | $0.00
 |  |  |  |  |  | Grand Total
