pranavs41/tar-team1-hardware/tools/vendor-order-template.xlsx

Item | Quantity | Cost per Item | Total Cost | Item/SKU Number | Other Specs if Applicable | Link | Total
 |  |  |  |  |  | Please select fastest shipping available | $0.00
 |  |  |  |  |  | Grand Total
