pranavs41/tar-team1-hardware/cad/network-drone-fc.step

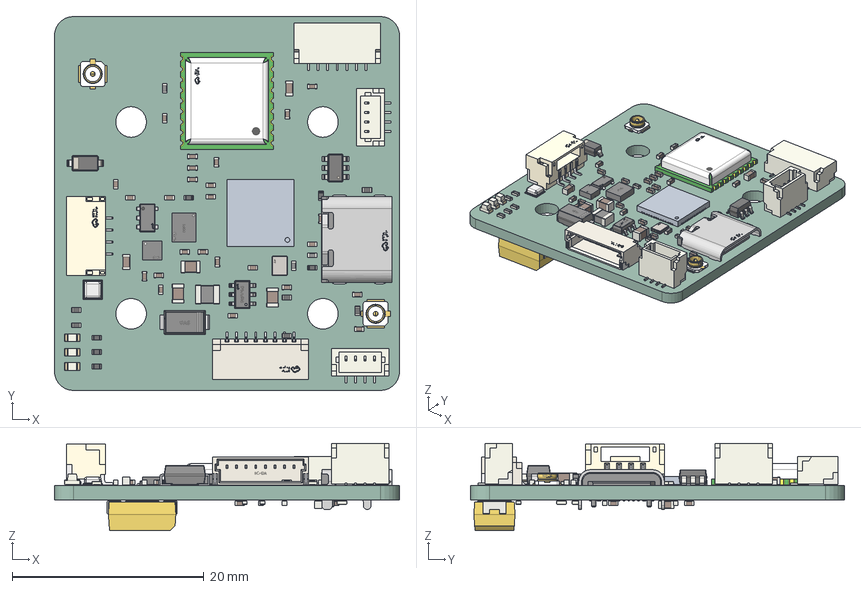
[picture p4: CAD file, 2026-10-17]
cad/network-drone-fc.step
36.0 x 39.0 x 9.10 mm
C_0402_1005Metric x 33
SMA_L4.4-W2.6-LS5.0-RD
R_0402_1005Metric x 15
LGA-10_L2.0-W2.0-P0.50-TL_BMP581
TSOT-23-6_L2.9-W1.6-H1.1-LS2.8-P0.95
SOT-23-6
LED_0603_1608Metric x 3
L_1008_2520Metric
L_0402_1005Metric x 3
C_0805_2012Metric x 3
C_0603_1608Metric x 3
JST_SH_BM04B-SRSS-TB_1x04-1MP_P1.00mm_Vertical x 2
SOT-23-5_L2.9-W1.6-P0.95-LS2.8-BR
CONN-SMD_GH1.25-WS-4P
USB-C-SMD_TYPE-C-6PIN-2MD-073
TDFN-6_L2.0-W2.0-H0.8-P0.65
D_SOD-123
network-drone-fc 1.42.1
LGA-14_L2.5-W3.0-H0.9-P0.50
CRYSTAL-SMD_4P-L2.0-W1.6-BL
JST_SH_SM07B-SRSS-TB_1x07-1MP_P1.00mm_Horizontal
RF-SMD_FRF05002-JSS103M x 2
SMD-18_L10.1-W9.7-P1.10-TL_SKG09F
CONN-SMD_SR1.00-WS-8P
CP_EIA-7343-31_Kemet-D
network-drone-fc_PCB
