pranavs41/tar-team1-hardware/pcb/network-drone-fc/production/rev-A/assembly-bottom.png

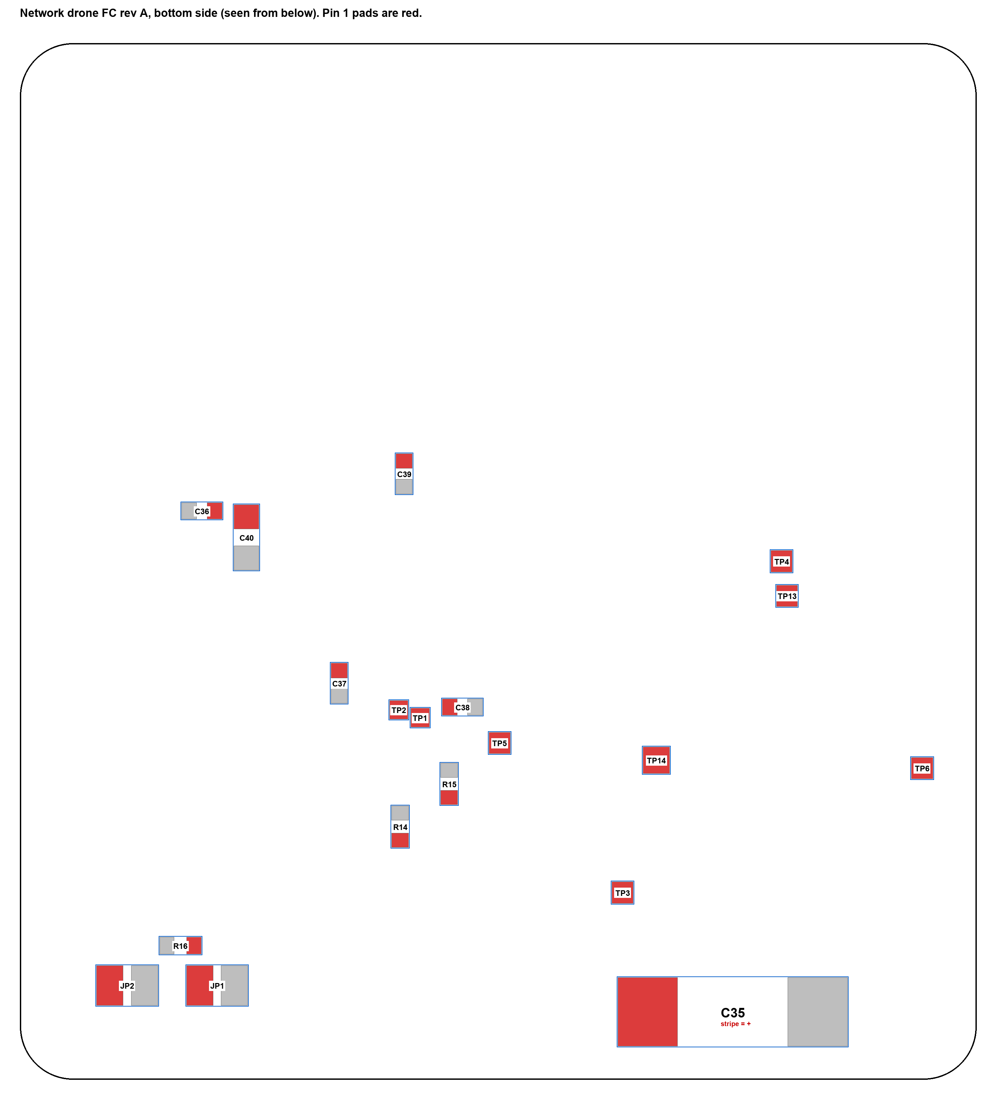
pcb/network-drone-fc/production/rev-A/assembly-bottom.png
