pranavs41/tar-team1-hardware/pcb/network-drone-fc/production/rev-A/assembly-top.png

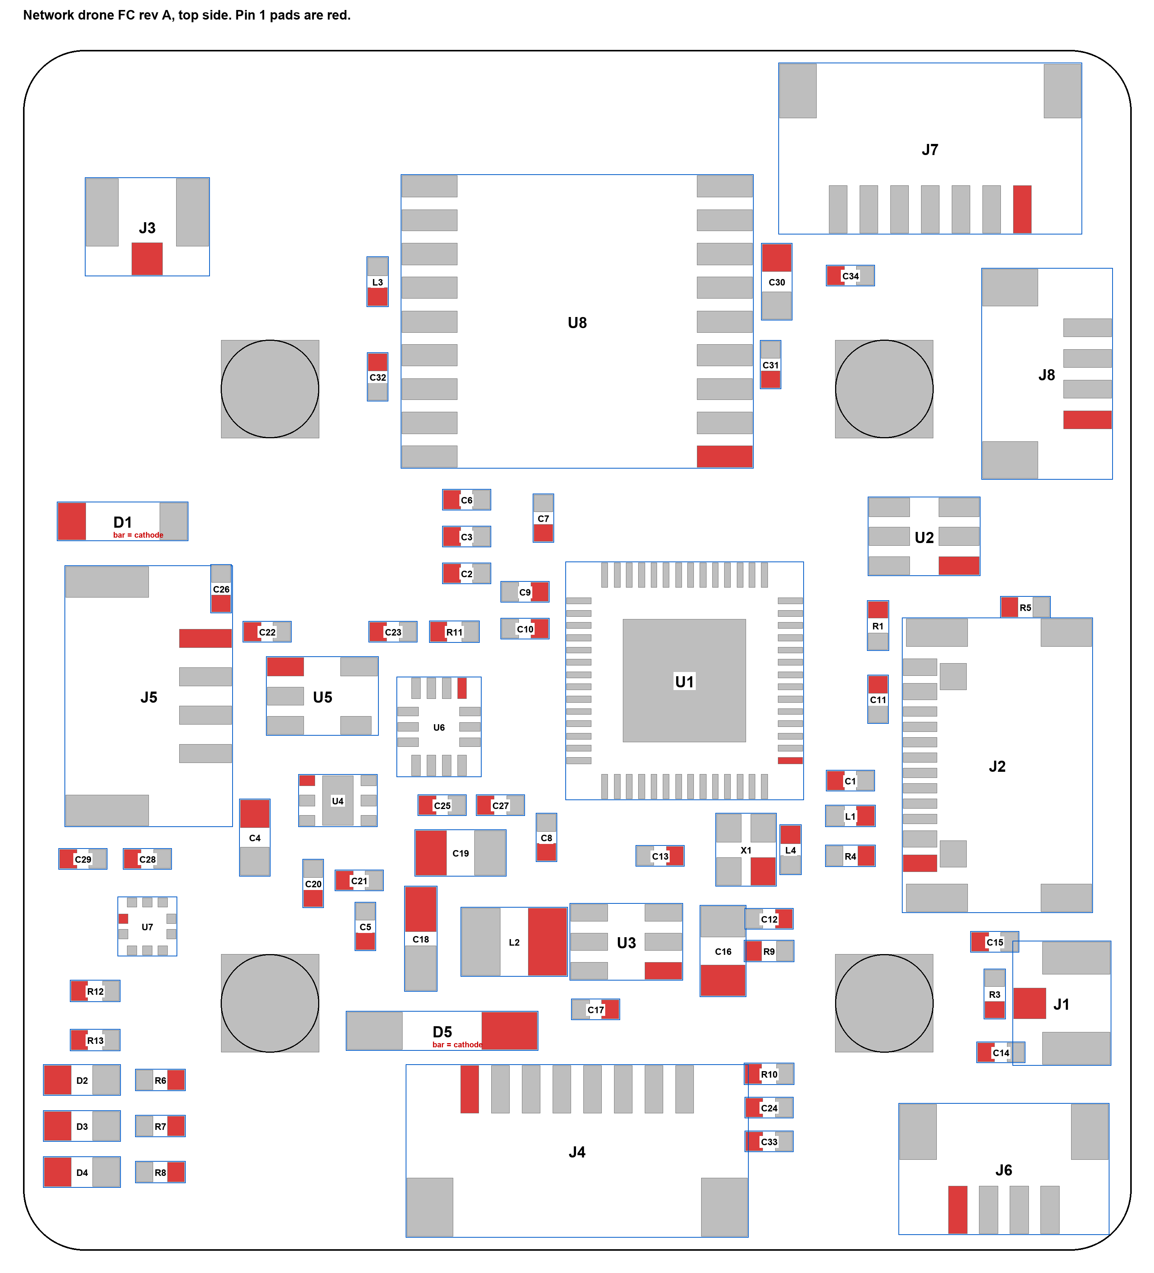
pcb/network-drone-fc/production/rev-A/assembly-top.png
