pranavs41/tar-team1-hardware/schematics/ground-station-main-schematic.pdf

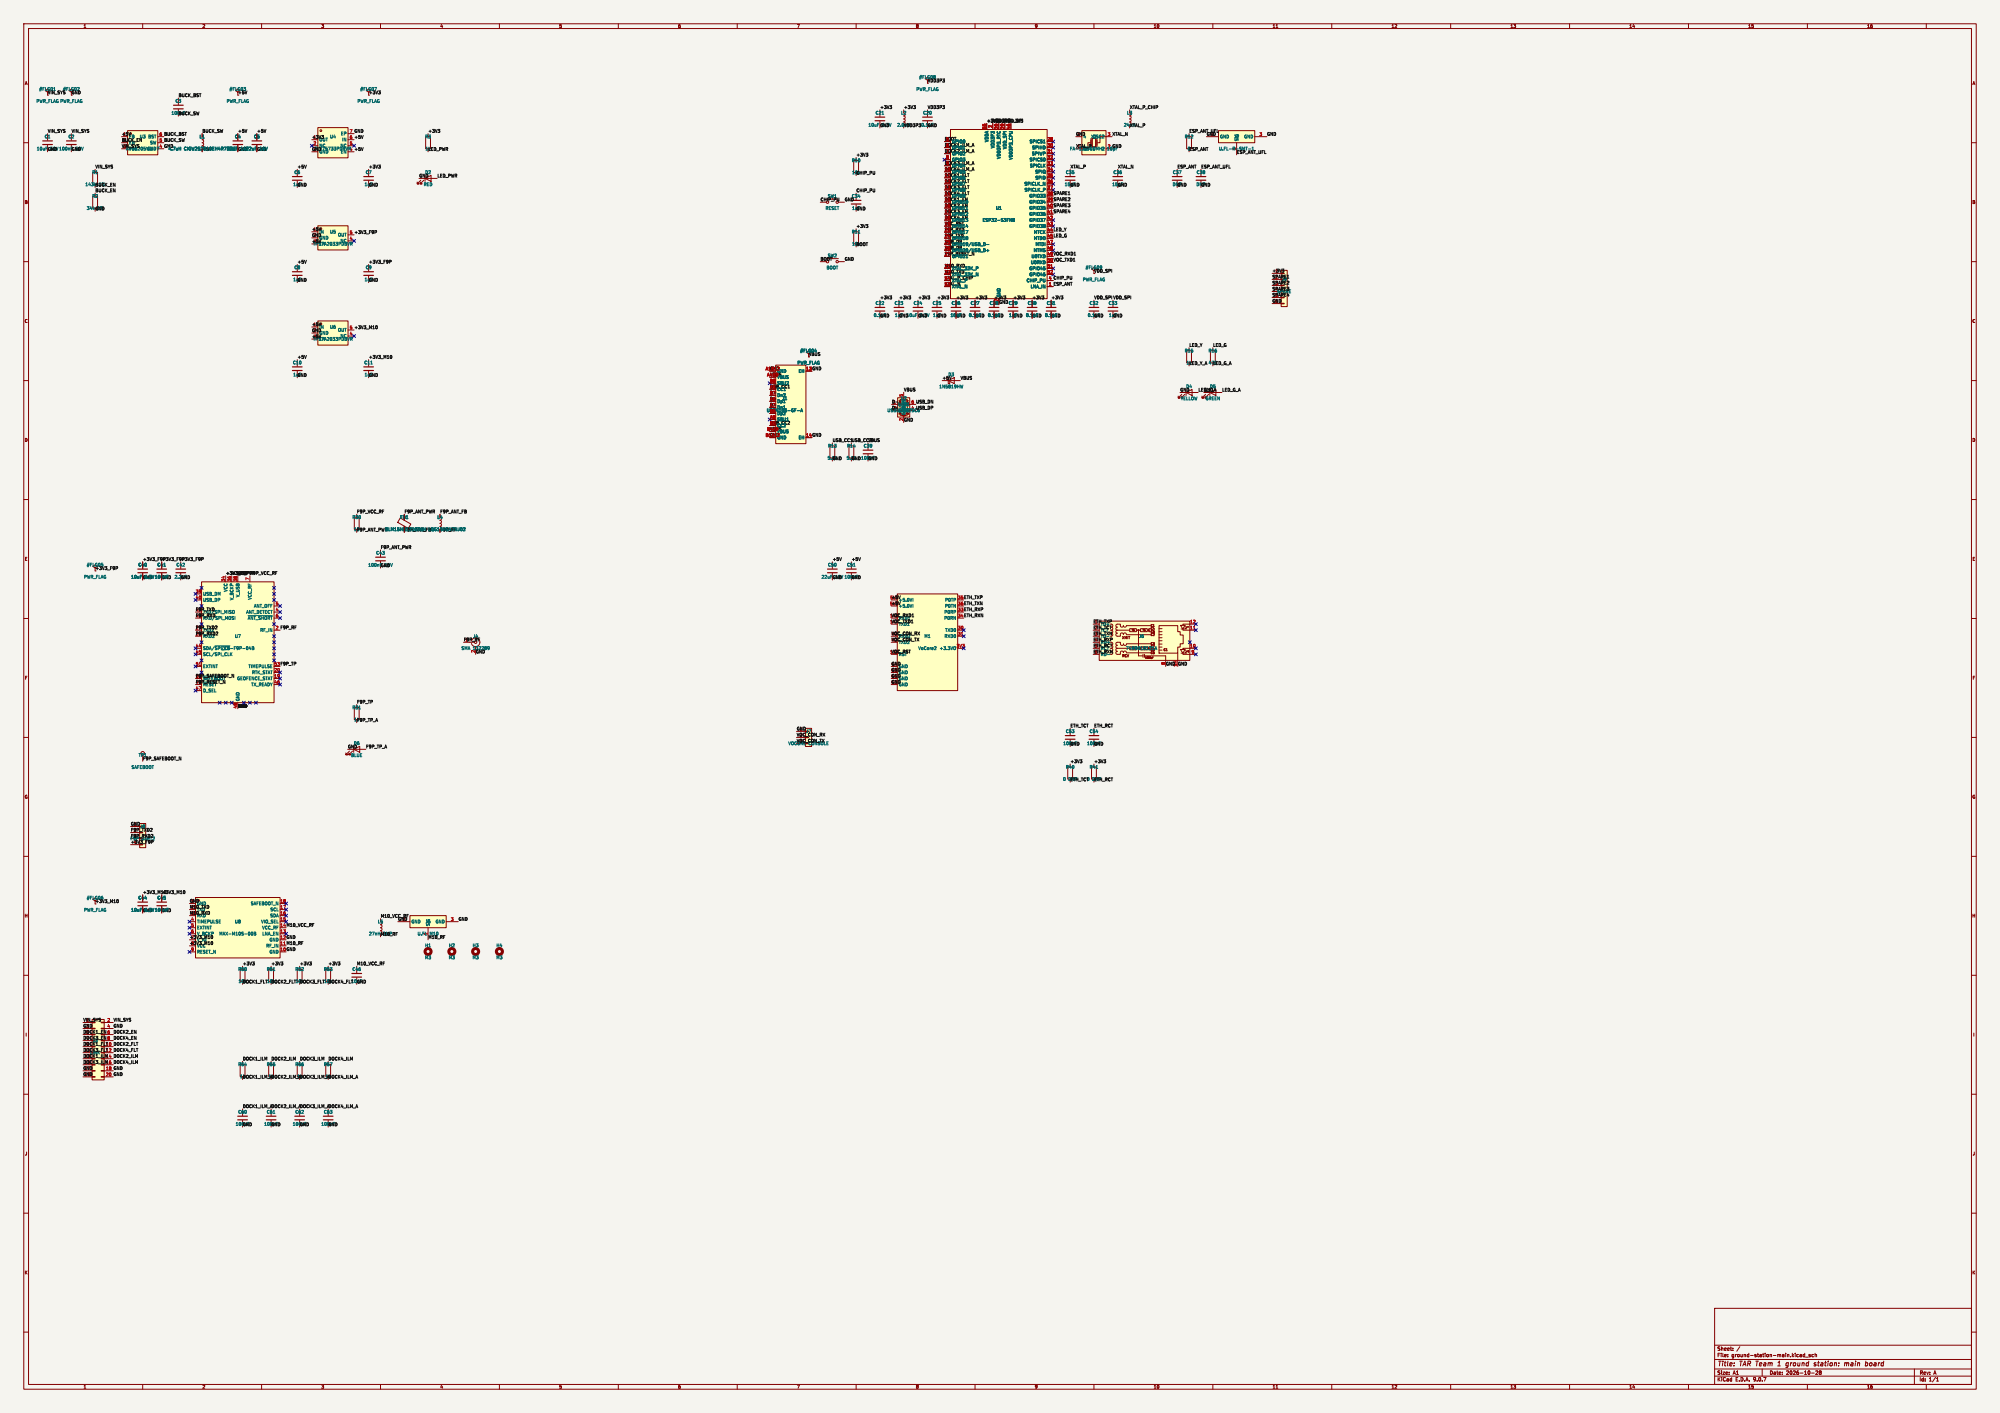
[picture p7: page 1]

VDD3P3 +3V3VDD_SPI +3V3 BOOT DOCK1_ILM_A DOCK2_ILM_A GND GND GND

File: ground-station-main.kicad_sch Sheet: /
Id: 1/1 Title: TAR Team 1 ground station: main board
