pranavs41/tar-team1-hardware/schematics/ground-station-power-schematic.pdf

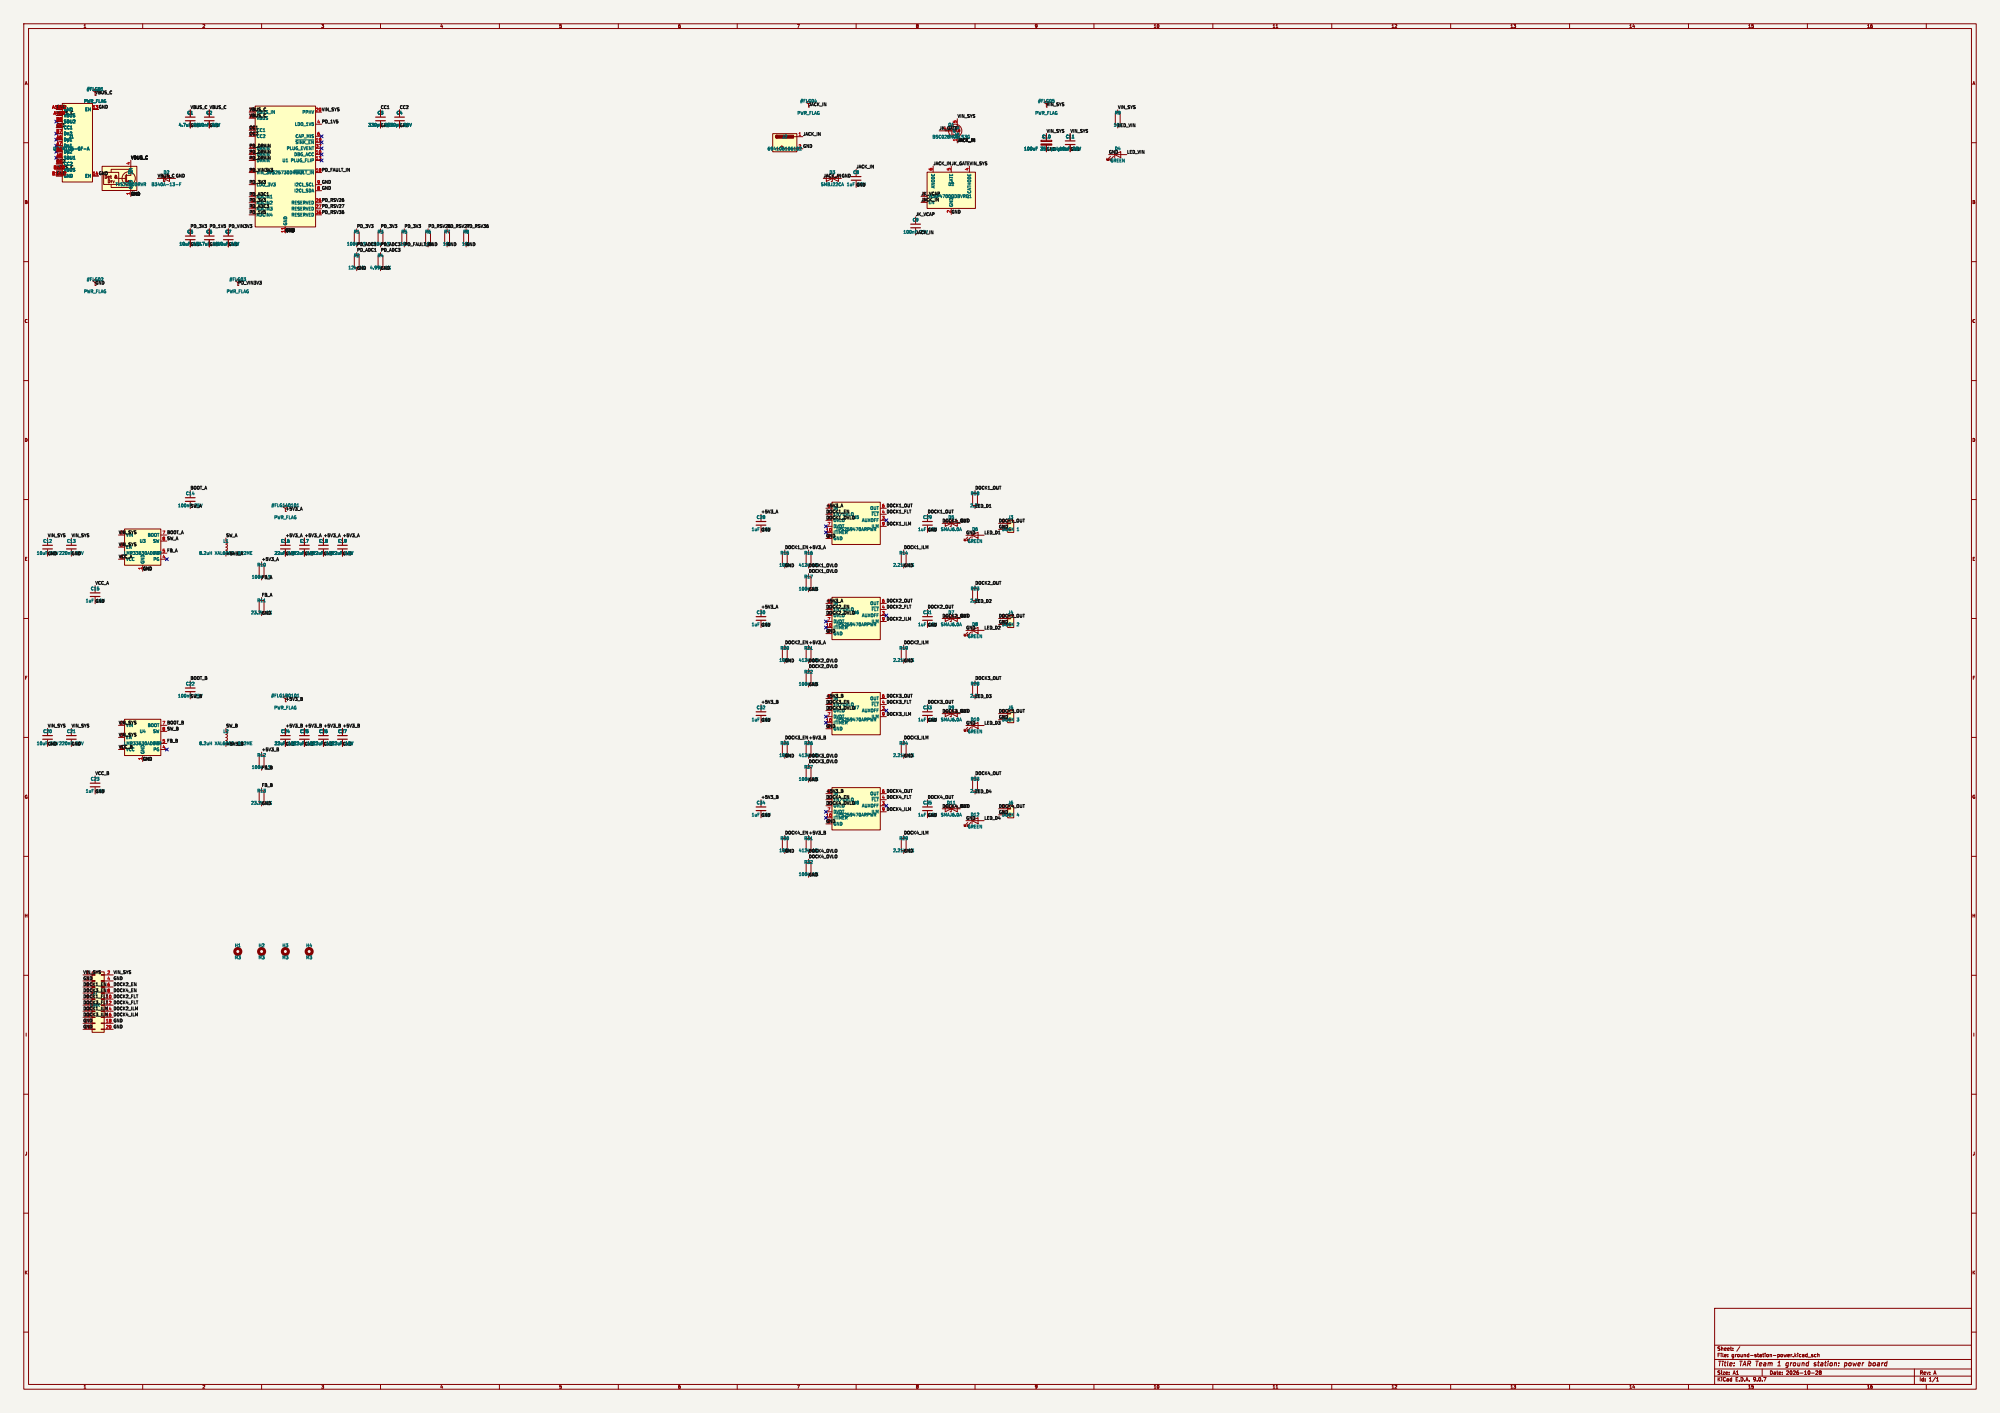
[picture p8: page 1]

1 BOOT 7 SW 8 FB 5 PG 4 U3
VCC_A GND

1 BOOT 7 SW 8 FB 5 PG 4 U4

File: ground-station-power.kicad_sch Sheet: /
Id: 1/1 Title: TAR Team 1 ground station: power board
