pranavs41/tar-team1-hardware/schematics/network-drone-fc-schematic.pdf

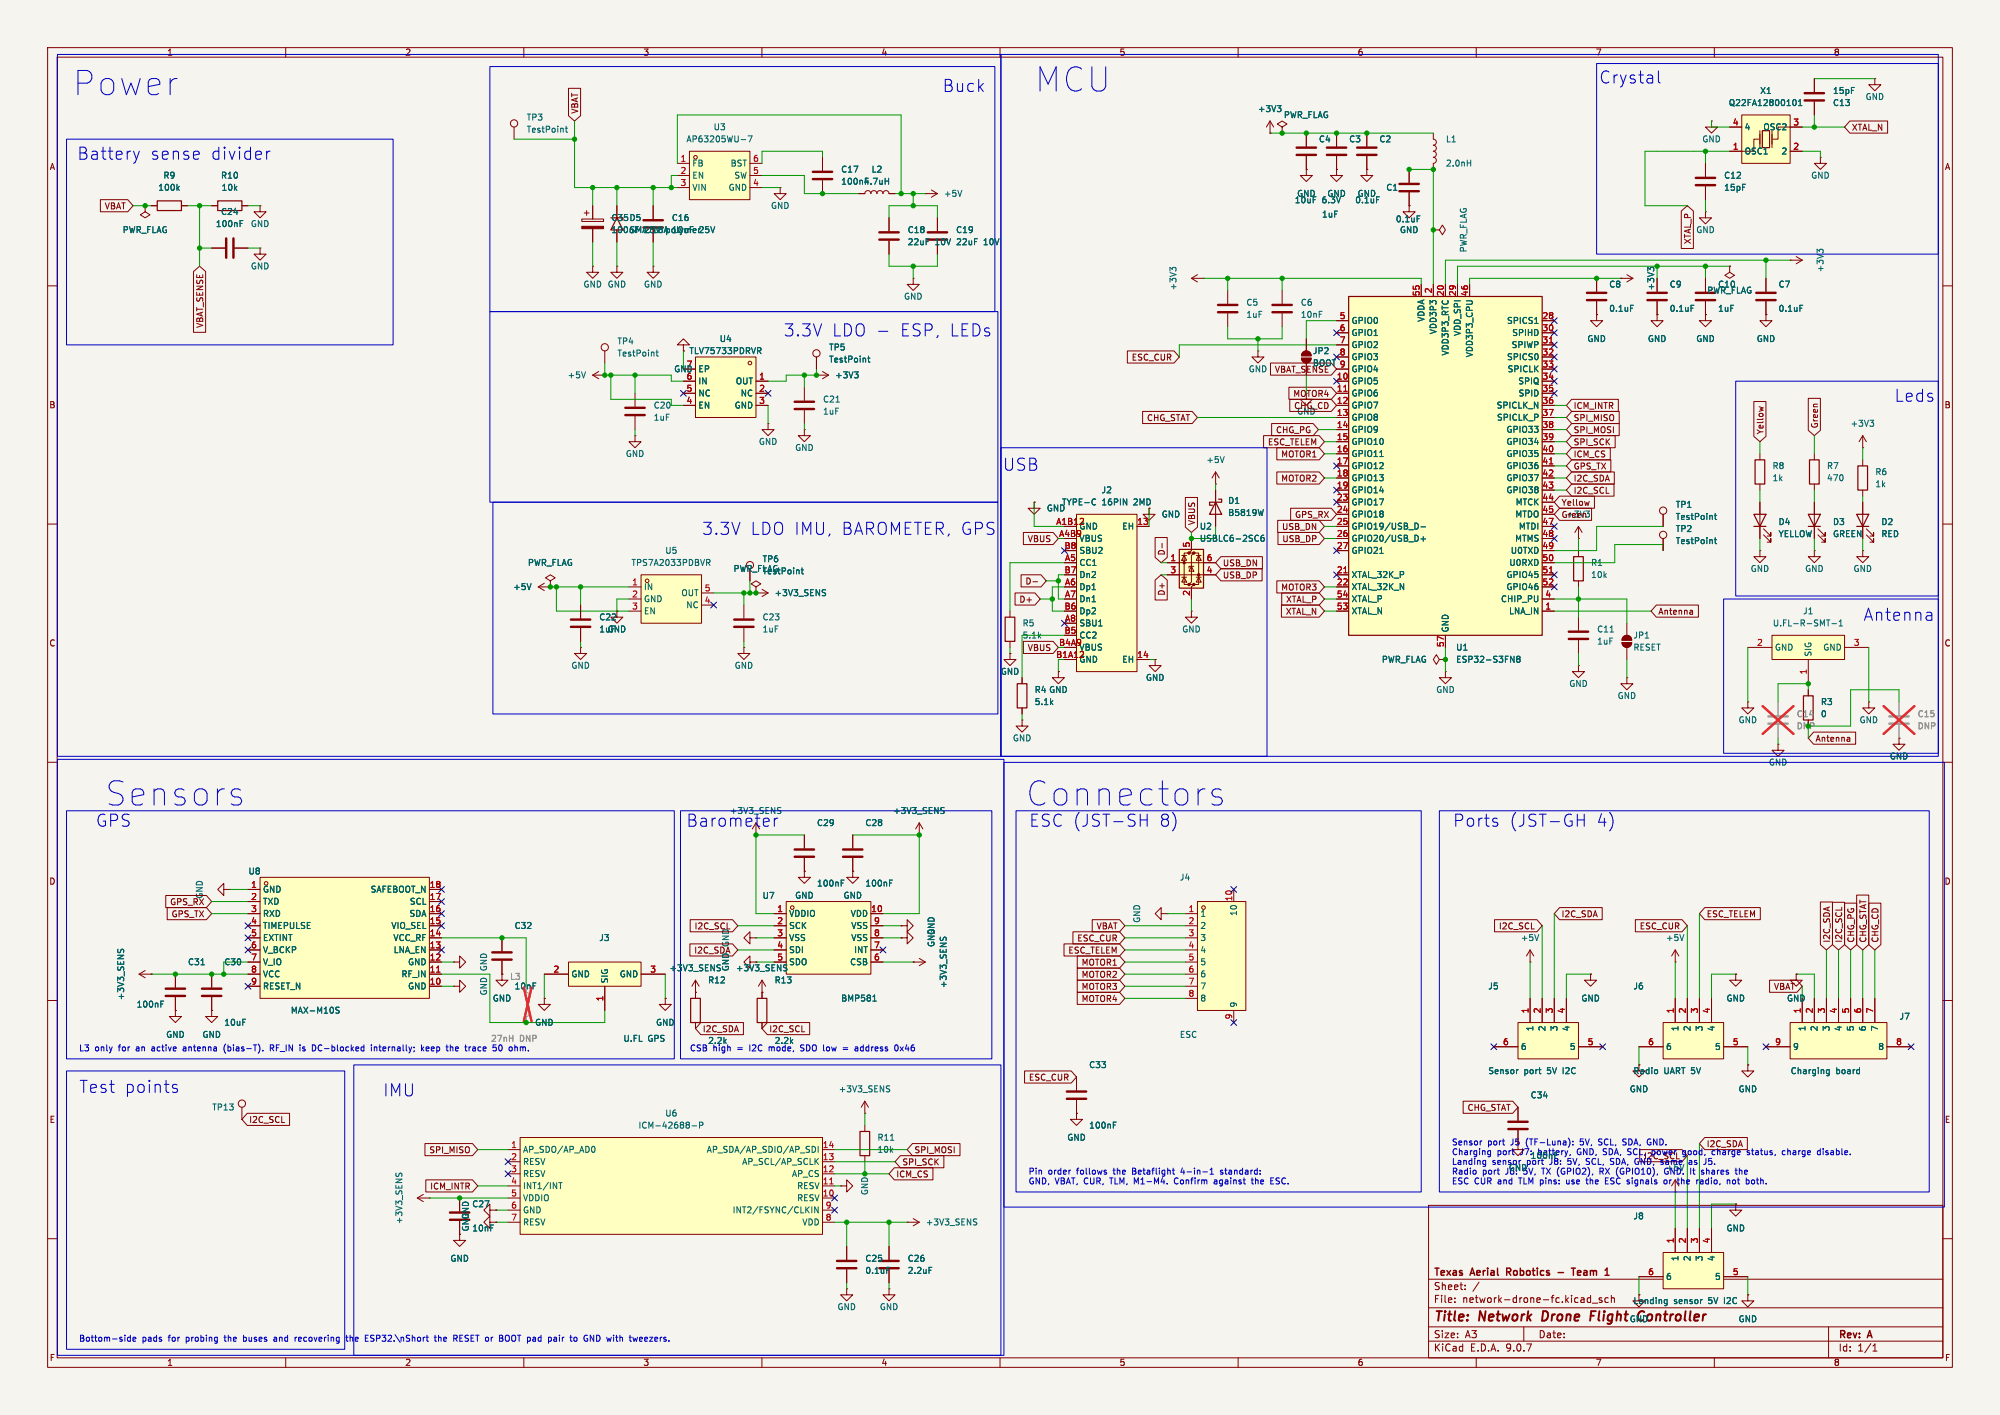
[picture p9: page 1]

2 VDD3P3_RTC 20 GND 57 VDD_SPI 29 VDD3P3_CPU 46 SPICS1 28 SPIHD 30 SPIWP 31 SPICS0 32 SPICLK 33 SPIQ 34 SPID 35 SPICLK_P 37 GPIO33 38 GPIO34 39 GPIO35 40 GPIO36 41 GPIO37 42 GPIO38 43 MTCK 44 MTDI 47 MTMS 48 U0TXD 49 U0RXD 50 GPIO46 52 CHIP_PU 4

TP5 TestPoint OUT 1 NC 2 GND 3 EP 7

TP5 TestPoint U4 TLV75733PDRVR OUT 1 NC 2 GND 3 EP 7

3.3V LDO IMU, BAROMETER, GPS

CSB high = I2C mode, SDO low = address 0x46 IMU
