pranavs41/tar-team1-hardware/pcb/network-drone-fc/network-drone-fc.kicad_pcb

## KiCad design pcb/network-drone-fc/network-drone-fc.kicad_pcb (2026-10-18)

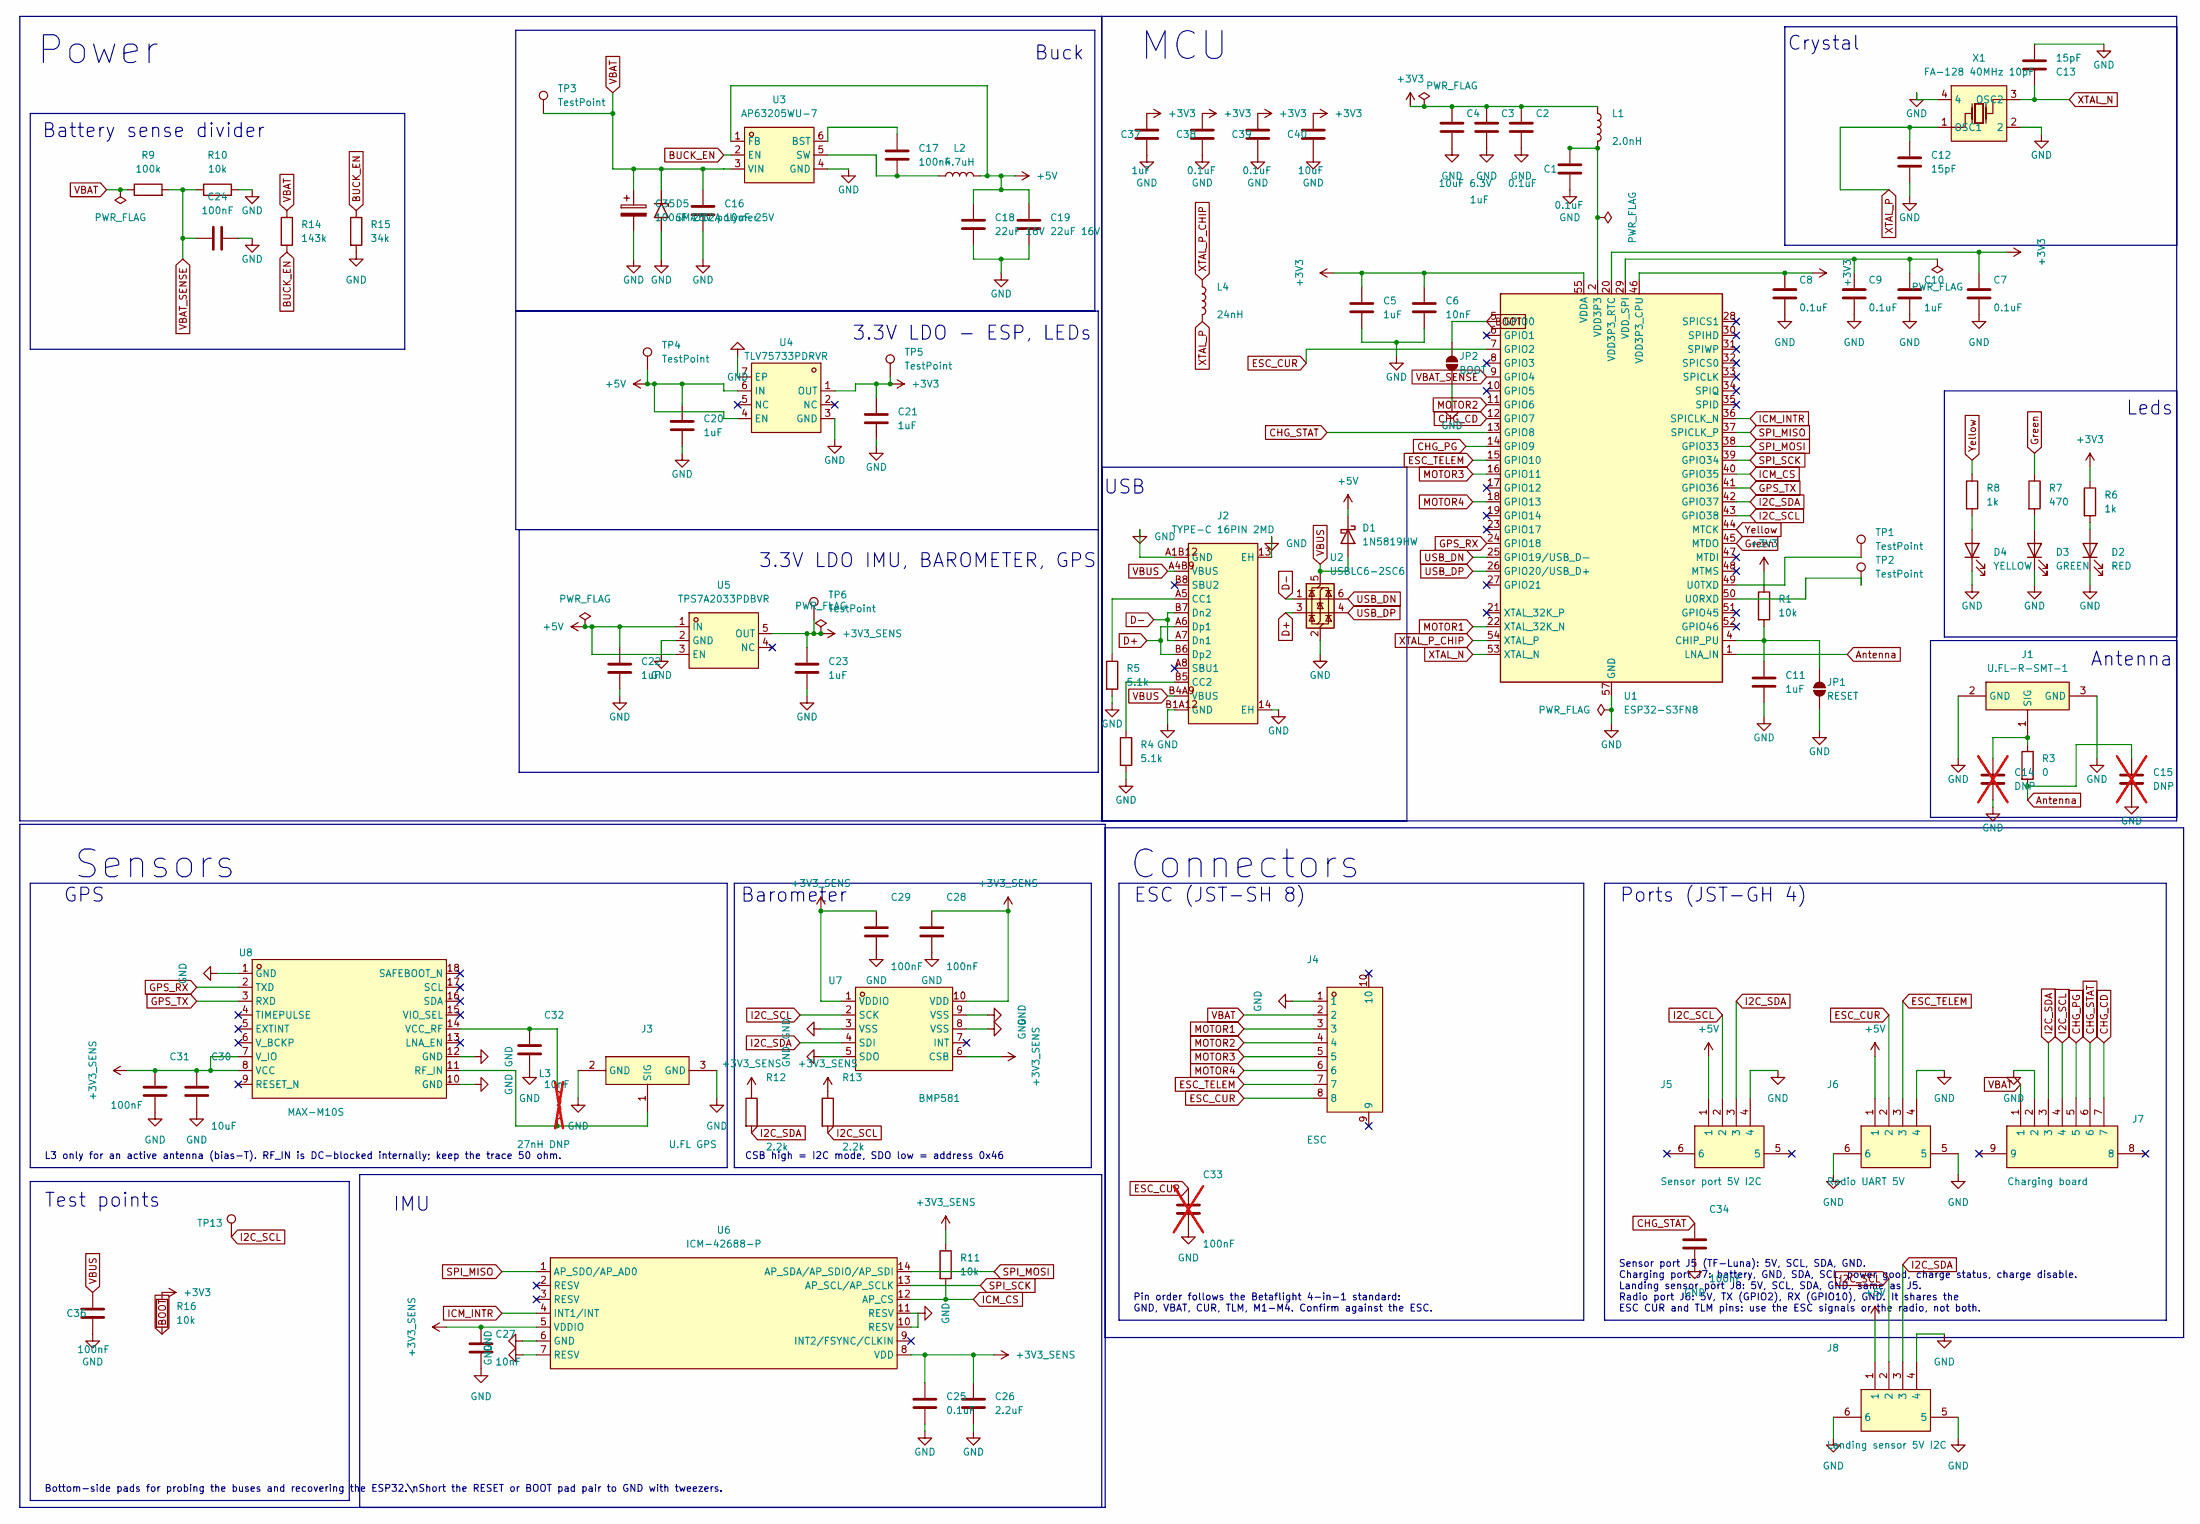
[picture p10: schematic network-drone-fc.kicad_sch, Network Drone Flight Controller]

Parts:
C1, C2, C7, C8, C9, C25, C38, C39: 0.1uF; C_0402_1005Metric
C3, C5, C10, C11, C20, C21, C22, C23, C37: 1uF; C_0402_1005Metric
C4: 10uF 6.3V; C_0603_1608Metric
C6, C27, C32: 10nF; C_0402_1005Metric
C12, C13: 15pF; C_0402_1005Metric
C14, C15: DNP; C_0402_1005Metric; not fitted
C16: 10uF 25V; C_0805_2012Metric
C17, C24, C28, C29, C31, C34, C36: 100nF; C_0402_1005Metric
C18, C19: 22uF 16V; C_0805_2012Metric
C26: 2.2uF; C_0402_1005Metric
C30, C40: 10uF; C_0603_1608Metric
C33: 100nF; C_0402_1005Metric; not fitted
C35: 100uF 25V polymer; CP_EIA-7343-31_Kemet-D_HandSolder
D1: 1N5819HW; D_SOD-123
D2: RED; LED_0603_1608Metric
D3: GREEN; LED_0603_1608Metric
D4: YELLOW; LED_0603_1608Metric
D5: SMAJ12A; SMA_L4.4-W2.6-LS5.0-RD
J1: U.FL-R-SMT-1; RF-SMD_FRF05002-JSS103M; MPN U.FL-R-SMT-1(80); LCSC Part C88374
J2: TYPE-C 16PIN 2MD; USB-C-SMD_TYPE-C-16PIN-2MD-073; MPN TYPE-C 16PIN 2MD(073); LCSC Part C2765186
J3: U.FL GPS; RF-SMD_FRF05002-JSS103M; LCSC C88374
J4: ESC; CONN-TH_SM08B-SRSS-TB-LF-SN; LCSC C160407
J5: Sensor port 5V I2C; CONN-SMD_4P-P1.25_SM04B-GHS-TB-LF-SN; LCSC C189895
J6: Radio UART 5V; JST_SH_BM04B-SRSS-TB_1x04_Vertical; LCSC C189895
J7: Charging board; JST_SH_SM07B-SRSS-TB_1x07_Horizontal
J8: Landing sensor 5V I2C; JST_SH_BM04B-SRSS-TB_1x04_Vertical; LCSC C189895
JP1: RESET; SolderJumper-2_P1.3mm_Open_RoundedPad1.0x1.5mm
JP2: BOOT; SolderJumper-2_P1.3mm_Open_RoundedPad1.0x1.5mm
L1: 2.0nH; L_0402_1005Metric
L2: 4.7uH; L_1008_2520Metric
L3: 27nH DNP; L_0402_1005Metric; not fitted
L4: 24nH; L_0402_1005Metric
R1, R10, R11, R16: 10k; R_0402_1005Metric
R3: 0; R_0402_1005Metric
R4, R5: 5.1k; R_0402_1005Metric
R6, R8: 1k; R_0402_1005Metric
R7: 470; R_0402_1005Metric
R9: 100k; R_0402_1005Metric
R12, R13: 2.2k; R_0402_1005Metric
R14: 143k; R_0402_1005Metric
R15: 34k; R_0402_1005Metric
TP1, TP2, TP3, TP4, TP5, TP6, TP13: TestPoint; TestPoint_Pad_D1.0mm
U1: ESP32-S3FN8; QFN-56-1EP_7x7mm_P0.4mm_EP4x4mm
U2: USBLC6-2SC6; SOT-23-6
U3: AP63205WU-7; TSOT-23-6_L2.9-W1.6-P0.95-LS2.8-BL; MPN AP63205WU-7; LCSC Part C2071056
U4: TLV75733PDRVR; TDFN-6_L2.0-W2.0-P0.65-TL-EP; MPN TLV75733PDRVR; LCSC Part C485517
U5: TPS7A2033PDBVR; SOT-23-5_L2.9-W1.6-P0.95-LS2.8-BR; MPN TPS7A2033PDBVR; LCSC Part C2862740
U6: ICM-42688-P; LGA-14_L3.0-W2.5-P0.50-TL; MPN ICM-42688-P; LCSC Part C1850418
U7: BMP581; LGA-10_L2.0-W2.0-P0.50-TL_BMP581; LCSC C5362283
U8: MAX-M10S; SMD-18_L10.1-W9.7-P1.10-TL_SKG09F; LCSC C4153167
X1: FA-128 40MHz 10pF; CRYSTAL-SMD_4P-L2.0-W1.6-BL; MPN Q22FA12800101; LCSC Part C255898

Connections:
+3V3: C2.1, C3.1, C4.1, C5.1, C6.1, C7.1, C8.1, C21.1, C37.1, C38.1, C39.1, C40.1, L1.1, R1.1, R6.1, R16.1, TP5.1, U1.20 (VDD3P3_RTC), U1.46 (VDD3P3_CPU), U1.55 (VDDA), U1.56 (VDDA), U4.1 (OUT)
+3V3_SENS: C23.1, C25.1, C26.2, C27.1, C28.1, C29.1, C30.1, C31.1, R11.1, R12.1, R13.1, TP6.1, U5.5 (OUT), U6.5 (VDDIO), U6.8 (VDD), U7.1 (VDDIO), U7.6 (CSB), U7.10 (VDD), U8.7 (V_IO), U8.8 (VCC)
Antenna: C15.1, R3.2, U1.1 (LNA_IN)
BOOT: JP2.2 (B), R16.2, U1.5 (GPIO0)
BUCK_EN: R14.2, R15.1, U3.2 (EN)
CHG_CD: J7.7, U1.12 (GPIO7)
CHG_PG: J7.5, U1.14 (GPIO9)
CHG_STAT: C34.1, J7.6, U1.13 (GPIO8)
D+: J2.A6 (Dp1), J2.B6 (Dp2), U2.3 (I/O2)
D-: J2.A7 (Dn1), J2.B7 (Dn2), U2.1 (I/O1)
ESC_CUR: C33.1, J4.8, J6.2, U1.7 (GPIO2)
ESC_TELEM: J4.7, J6.3, U1.15 (GPIO10)
GPS_RX: U1.24 (GPIO18), U8.2 (TXD)
GPS_TX: U1.41 (GPIO36), U8.3 (RXD)
Green: R7.1, U1.45 (MTDO)
I2C_SCL: J5.2, J7.4, J8.2, R13.2, TP13.1, U1.43 (GPIO38), U7.2 (SCK)
I2C_SDA: J5.3, J7.3, J8.3, R12.2, U1.42 (GPIO37), U7.4 (SDI)
ICM_CS: R11.2, U1.40 (GPIO35), U6.12 (AP_CS)
ICM_INTR: U1.36 (SPICLK_N), U6.4 (INT1/INT)
MOTOR1: J4.3, U1.22 (XTAL_32K_N)
MOTOR2: J4.4, U1.11 (GPIO6)
MOTOR3: J4.5, U1.16 (GPIO11)
MOTOR4: J4.6, U1.18 (GPIO13)
unnamed: C1.1, L1.2, U1.2 (VDD3P3), U1.3 (VDD3P3)
unnamed: D2.2 (A), R6.2
unnamed: D3.2 (A), R7.2
unnamed: D4.2 (A), R8.2
unnamed: C14.1, J1.1 (SIG), R3.1
unnamed: J2.A5 (CC1), R5.1
unnamed: J2.B5 (CC2), R4.1
unnamed: J3.1 (SIG), L3.2, U8.11 (RF_IN)
unnamed: C11.1, JP1.2 (B), R1.2, U1.4 (CHIP_PU)
unnamed: TP2.1, U1.50 (U0RXD)
unnamed: TP1.1, U1.49 (U0TXD)
unnamed: C9.1, C10.1, U1.29 (VDD_SPI)
unnamed: C17.1, U3.6 (BST)
unnamed: C17.2, L2.1, U3.5 (SW)
unnamed: C32.1, L3.1, U8.14 (VCC_RF)
SPI_MISO: U1.37 (SPICLK_P), U6.1 (AP_SDO/AP_AD0)
SPI_MOSI: U1.38 (GPIO33), U6.14 (AP_SDA/AP_SDIO/AP_SDI)
SPI_SCK: U1.39 (GPIO34), U6.13 (AP_SCL/AP_SCLK)
USB_DN: U1.25 (GPIO19/USB_D-), U2.6 (I/O1)
USB_DP: U1.26 (GPIO20/USB_D+), U2.4 (I/O2)
VBAT: C16.1, C35.1, D5.1 (A1), J4.2, J7.1, R9.1, R14.1, TP3.1, U3.3 (VIN)
VBAT_SENSE: C24.1, R9.2, R10.1, U1.9 (GPIO4)
VBUS: C36.1, D1.2 (A), J2.A4B9 (VBUS), J2.B4A9 (VBUS), U2.5 (VBUS)
XTAL_N: C13.1, U1.53 (XTAL_N), X1.3 (OSC2)
XTAL_P: C12.1, L4.2, X1.1 (OSC1)
XTAL_P_CHIP: L4.1, U1.54 (XTAL_P)
Yellow: R8.1, U1.44 (MTCK)

Notes on the sheet:
Power
Buck
Connectors
USB
Leds
MCU
3.3V LDO IMU, BAROMETER, GPS
3.3V LDO - ESP, LEDs
IMU
Crystal
Antenna
Battery sense divider
Sensors
Barometer
CSB high = I2C mode, SDO low = address 0x46
GPS
L3 only for an active antenna (bias-T). RF_IN is DC-blocked internally; keep the trace 50 ohm.
ESC (JST-SH 8)
Pin order follows the Betaflight 4-in-1 standard: GND, VBAT, CUR, TLM, M1-M4. Confirm against the ESC.
Ports (JST-GH 4)
Sensor port J5 (TF-Luna): 5V, SCL, SDA, GND. Charging port J7: battery, GND, SDA, SCL, power good, charge status, charge disable. Landing sensor port J8: 5V, SCL, SDA, GND, same as J5. Radio port J6: 5V, TX (GPIO2), RX (GPIO10), GND. It shares the ESC CUR and TLM pins: use the ESC signals or the ra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
Test points
Bottom-side pads for probing the buses and recovering the ESP32.\nShort the RESET or BOOT pad pair to GND with tweezers.

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
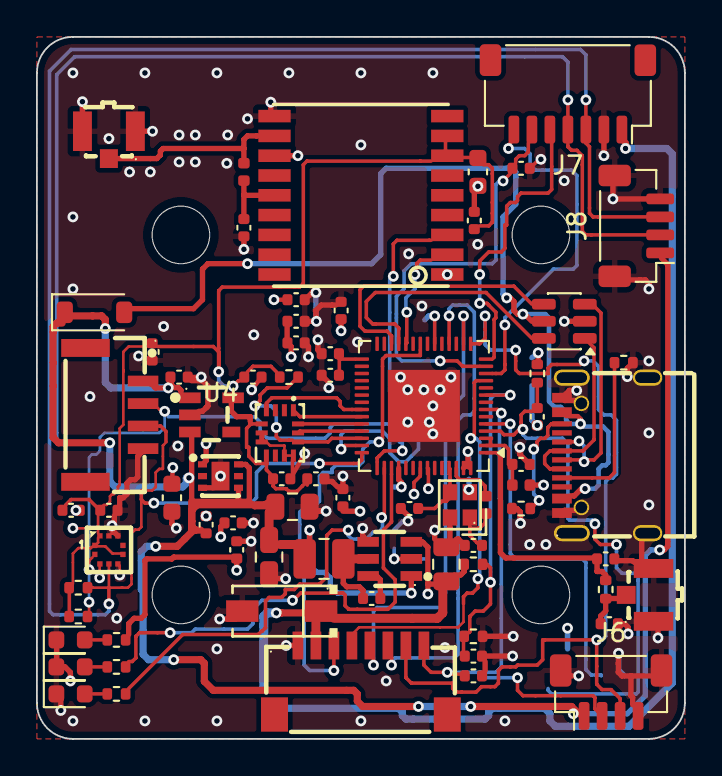
[picture p11: board network-drone-fc.kicad_pcb from above]

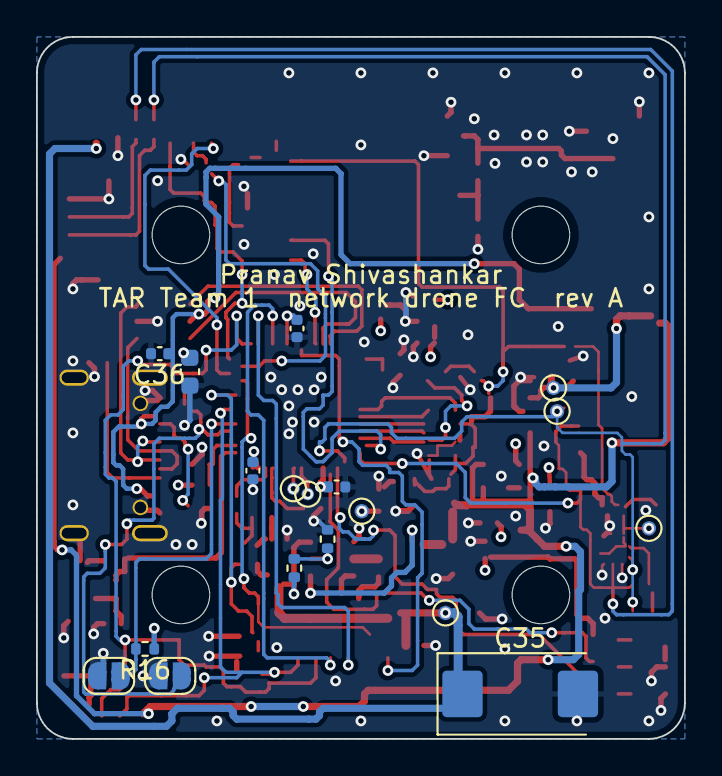
[picture p12: board network-drone-fc.kicad_pcb from below]

Board: 4 copper layers, 36.0 x 39.0 mm, 94 parts (18 on the bottom side), 52 nets.

Other parts of the board:
H1, H2, H3, H4: MountingHole_3.2mm_M3
