pranavs41/tar-team1-hardware/pcb/ground-station/main/ground-station-main.kicad_sch

## KiCad design pcb/ground-station/main/ground-station-main.kicad_sch (2026-10-29)

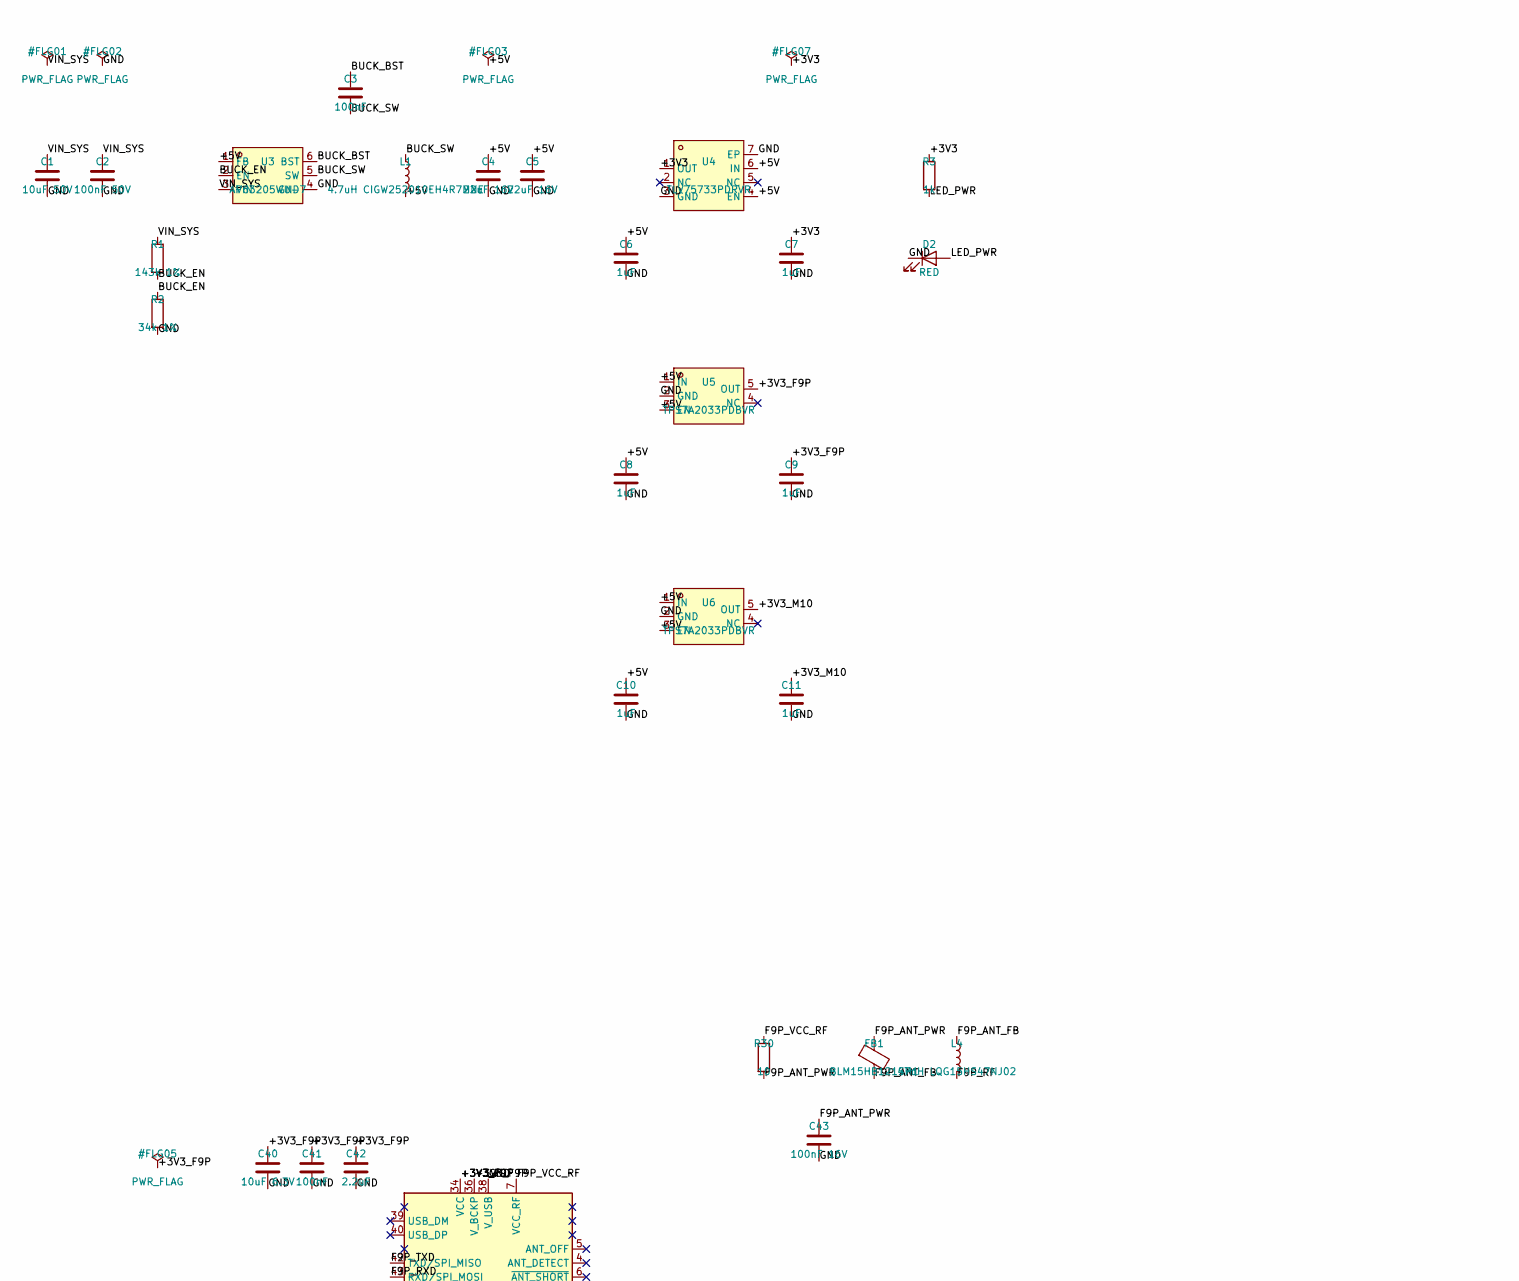
[picture p13: schematic ground-station-main.kicad_sch, part in row 1, column 1]

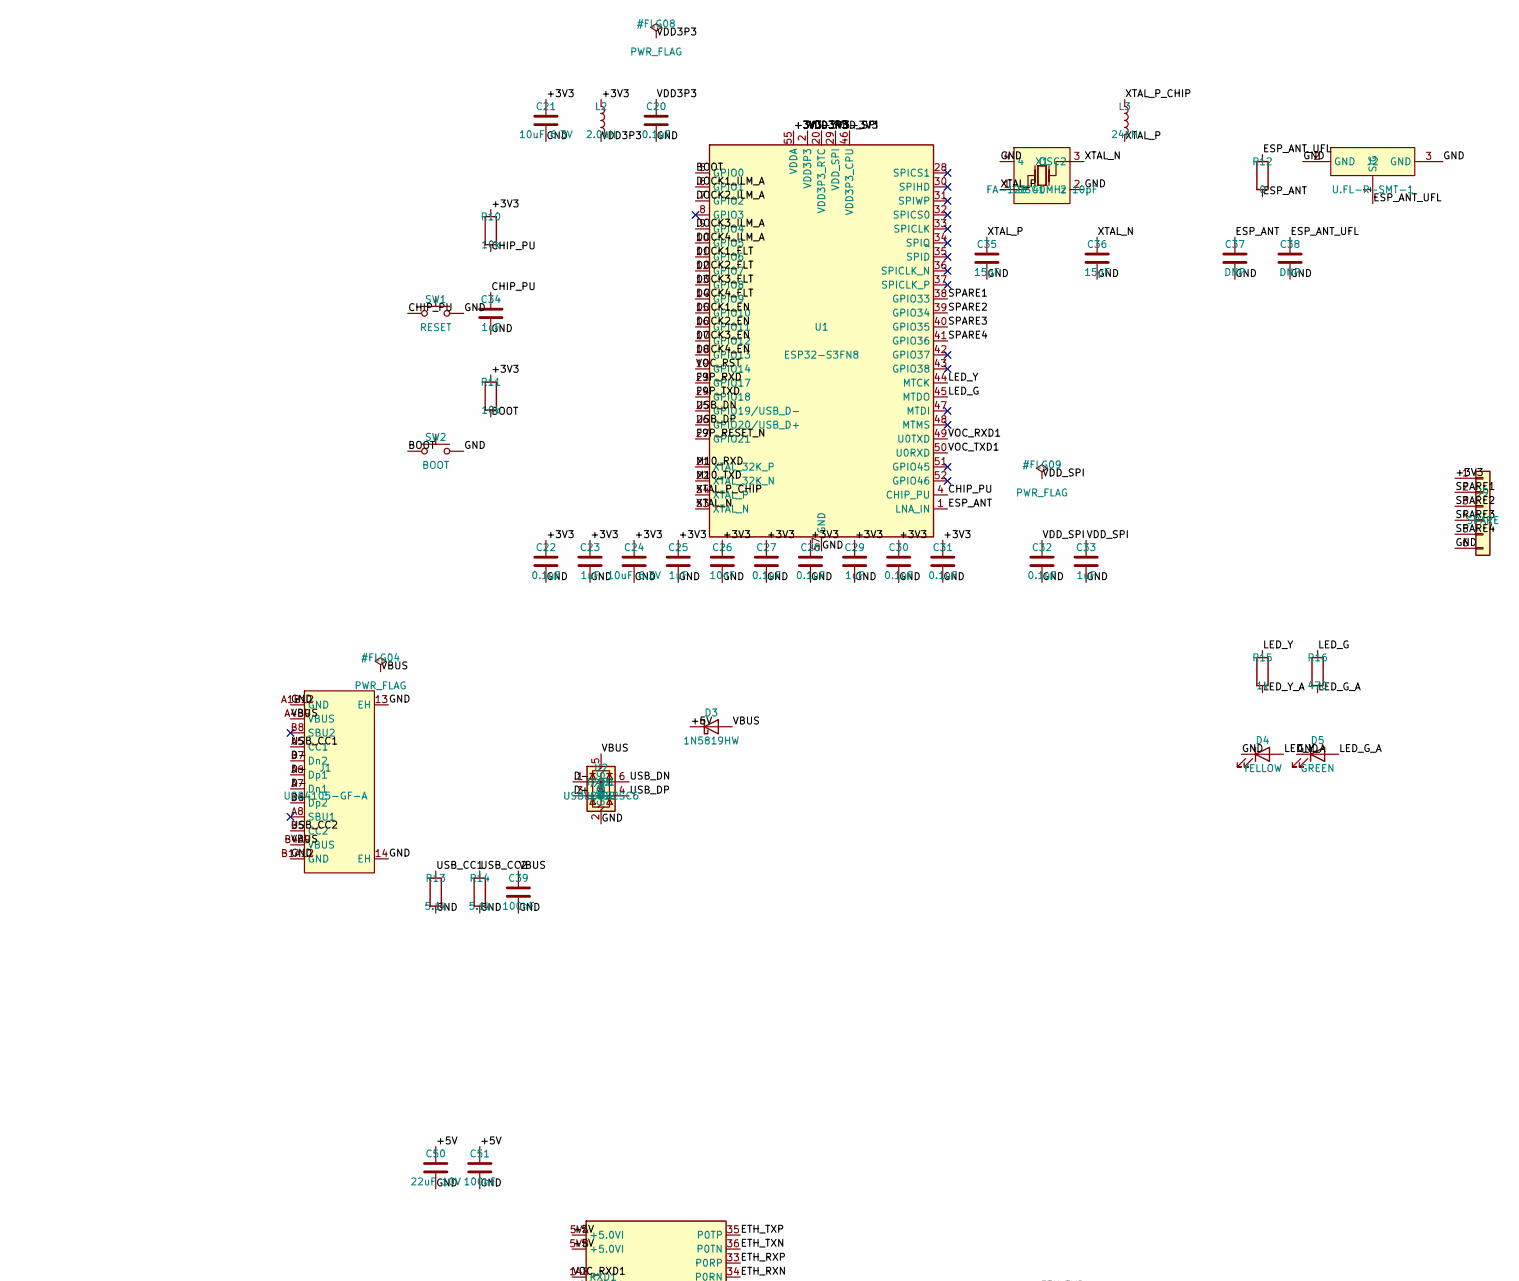
[picture p14: schematic ground-station-main.kicad_sch, part in row 1, column 2]

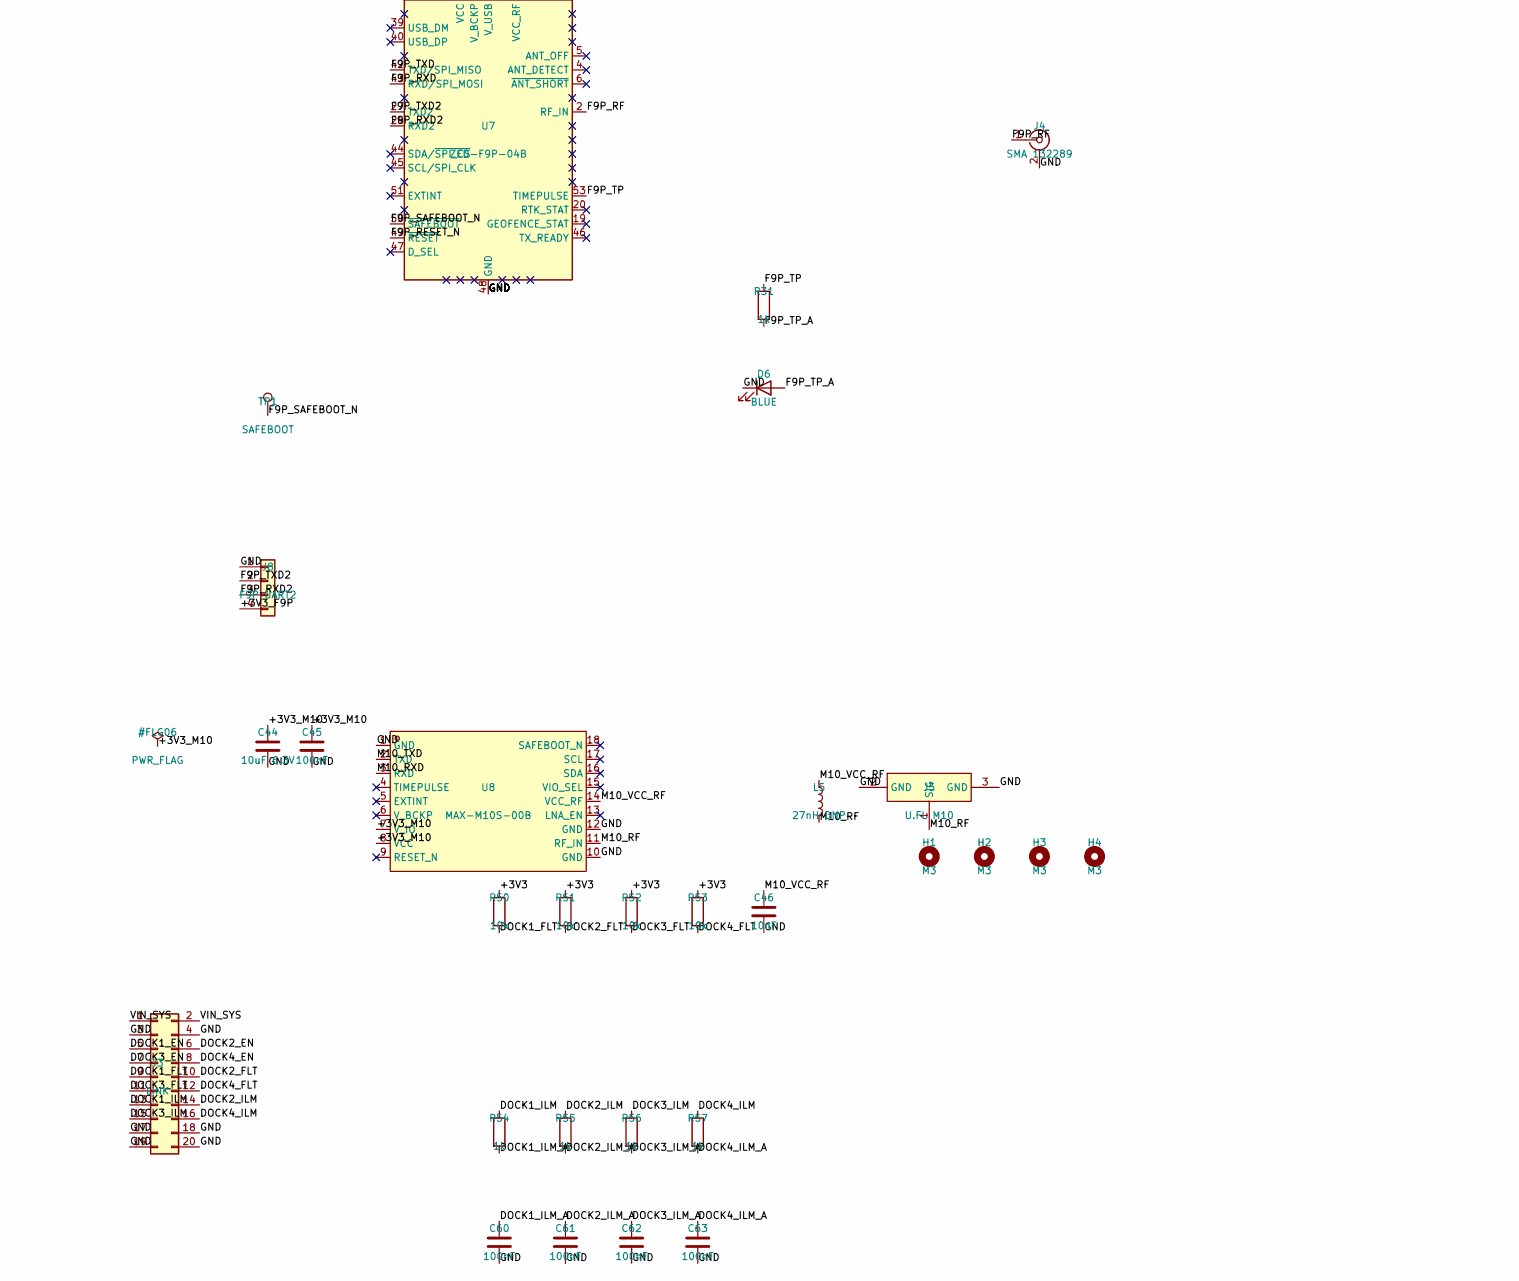
[picture p15: schematic ground-station-main.kicad_sch, part in row 2, column 1]

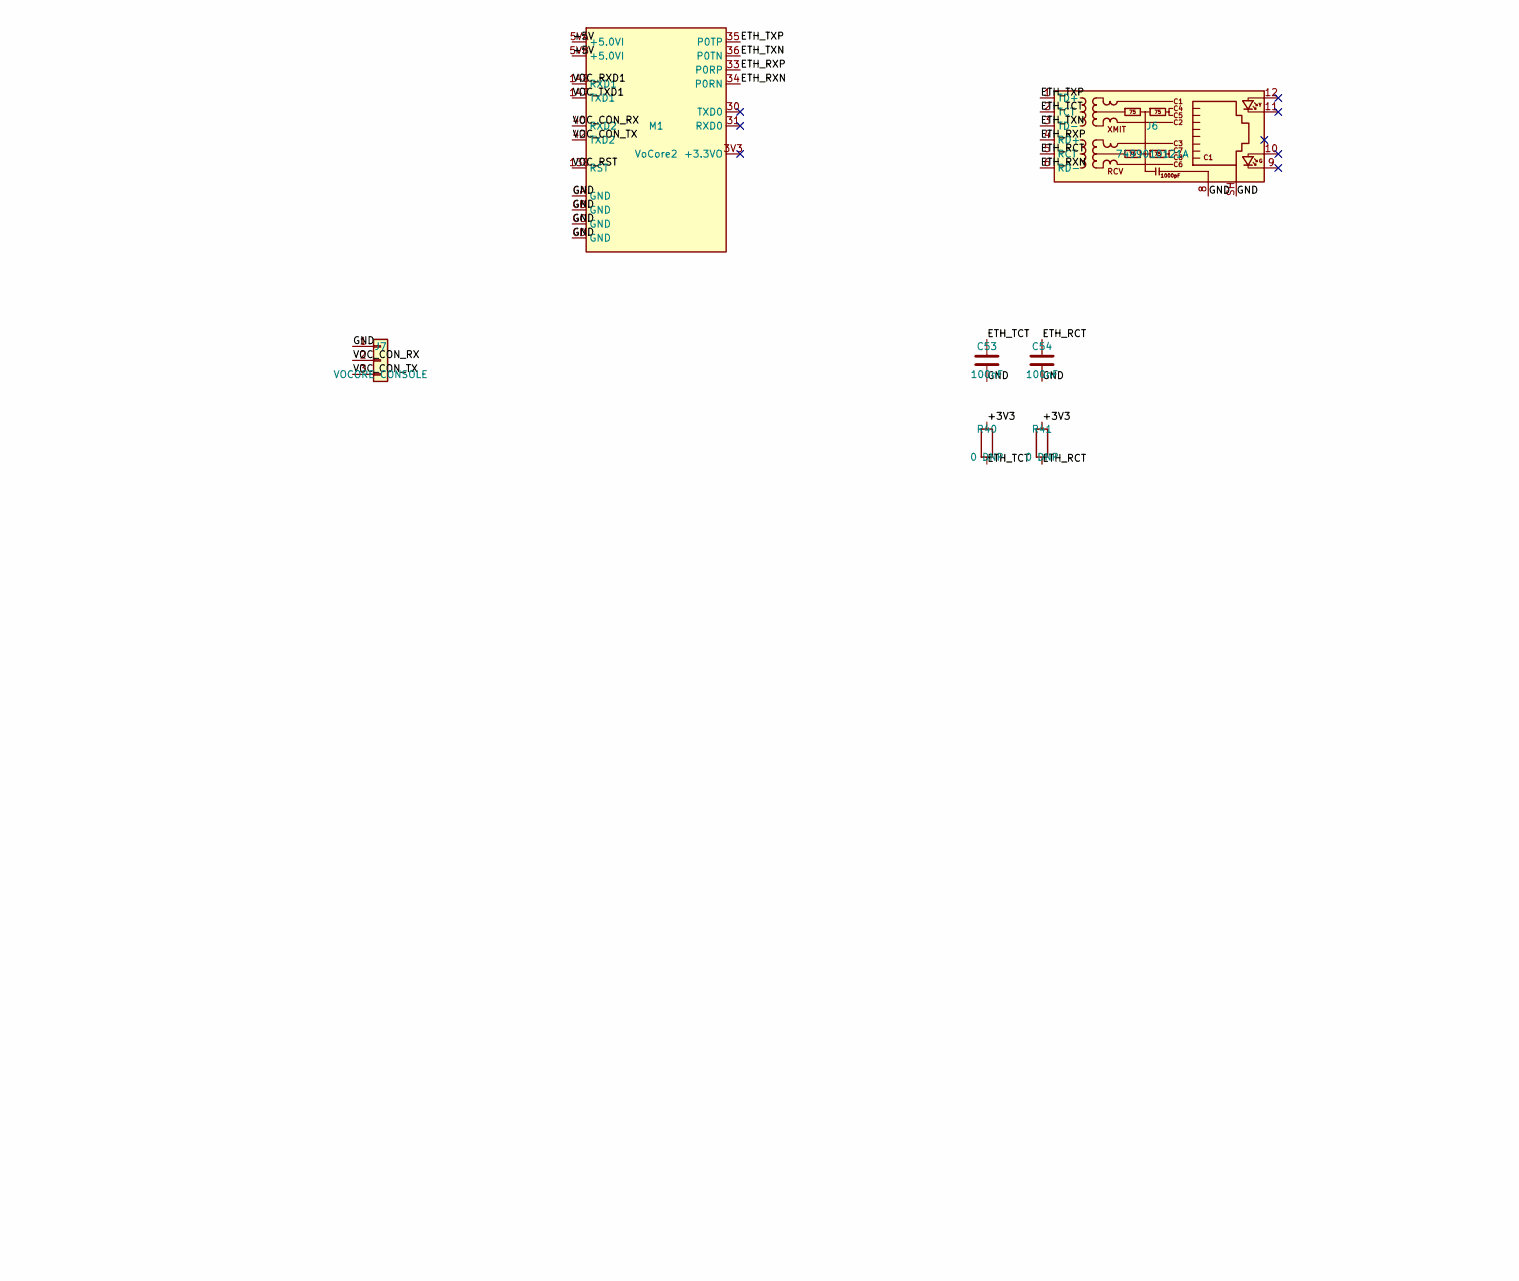
[picture p16: schematic ground-station-main.kicad_sch, part in row 2, column 2]

Parts:
C1: 10uF 50V; C_1210_3225Metric
C2: 100nF 50V; C_0402_1005Metric
C3, C39, C41, C45, C51, C53, C54, C60, C61, C62, C63: 100nF; C_0402_1005Metric
C4, C5: 22uF 16V; C_0805_2012Metric
C6, C7, C8, C9, C10, C11, C23, C25, C29, C33, C34: 1uF; C_0402_1005Metric
C20, C22, C27, C28, C30, C31, C32: 0.1uF; C_0402_1005Metric
C21, C24, C40, C44: 10uF 6.3V; C_0603_1608Metric
C26, C46: 10nF; C_0402_1005Metric
C35, C36: 15pF; C_0402_1005Metric
C37, C38: DNP; C_0402_1005Metric
C42: 2.2uF; C_0402_1005Metric
C43: 100nF 16V; C_0402_1005Metric
C50: 22uF 10V; C_0805_2012Metric
D2: RED; LED_0603_1608Metric
D3: 1N5819HW; D_SOD-123
D4: YELLOW; LED_0603_1608Metric
D5: GREEN; LED_0603_1608Metric
D6: BLUE; LED_0603_1608Metric
FB1: BLM15HB121SH1; L_0402_1005Metric
H1, H2, H3, H4: M3; MountingHole_3.2mm_M3
J1: USB4105-GF-A; USB-C-SMD_TYPE-C-16PIN-2MD-073
J2: U.FL-R-SMT-1; RF-SMD_FRF05002-JSS103M
J3: LINK; IDC-Header_2x10_P2.54mm_Vertical
J4: SMA 132289; SMA_Amphenol_132289_EdgeMount
J5: U.FL M10; RF-SMD_FRF05002-JSS103M
J6: 7499010121A; RJ45_Wuerth_7499010121A_Horizontal
J7: VOCORE CONSOLE; PinHeader_1x03_P2.54mm_Vertical
J8: F9P UART2; JST_SH_BM04B-SRSS-TB_1x04-1MP_P1.00mm_Vertical
J9: SPARE; PinHeader_1x06_P2.54mm_Vertical
L1: 4.7uH CIGW252010EH4R7MNE; L_1008_2520Metric
L2: 2.0nH; L_0402_1005Metric
L3: 24nH; L_0402_1005Metric
L4: 47nH LQG15HS47NJ02; L_0402_1005Metric
L5: 27nH DNP; L_0402_1005Metric
M1: VoCore2
R1: 143k 1%; R_0402_1005Metric
R2: 34k 1%; R_0402_1005Metric
R3, R15, R31, R54, R55, R56, R57: 1k; R_0402_1005Metric
R10, R11, R50, R51, R52, R53: 10k; R_0402_1005Metric
R12: 0; R_0402_1005Metric
R13, R14: 5.1k; R_0402_1005Metric
R16: 470; R_0402_1005Metric
R30: 10; R_0402_1005Metric
R40, R41: 0 DNP; R_0402_1005Metric
SW1: RESET; SW_SPST_TL3342
SW2: BOOT; SW_SPST_TL3342
TP1: SAFEBOOT; TestPoint_Pad_D1.0mm
U1: ESP32-S3FN8; QFN-56-1EP_7x7mm_P0.4mm_EP4x4mm
U2: USBLC6-2SC6; SOT-23-6
U3: AP63205WU-7; TSOT-23-6_L2.9-W1.6-P0.95-LS2.8-BL
U4: TLV75733PDRVR; TDFN-6_L2.0-W2.0-P0.65-TL-EP
U5, U6: TPS7A2033PDBVR; SOT-23-5_L2.9-W1.6-P0.95-LS2.8-BR
U7: ZED-F9P-04B; ublox_ZED
U8: MAX-M10S-00B; SMD-18_L10.1-W9.7-P1.10-TL_SKG09F
X1: FA-128 40MHz 10pF; CRYSTAL-SMD_4P-L2.0-W1.6-BL

Connections:
+3V3: C7.1, C21.1, C22.1, C23.1, C24.1, C25.1, C26.1, C27.1, C28.1, C29.1, C30.1, C31.1, J9.1, L2.1, R3.1, R10.1, R11.1, R40.1, R41.1, R50.1, R51.1, R52.1, R53.1, U1.20 (VDD3P3_RTC), U1.46 (VDD3P3_CPU), U1.55 (VDDA), U1.56 (VDDA), U4.1 (OUT)
+3V3_F9P: C9.1, C40.1, C41.1, C42.1, J8.4, U5.5 (OUT), U7.33 (VCC), U7.34 (VCC), U7.36 (V_BCKP)
+3V3_M10: C11.1, C44.1, C45.1, U6.5 (OUT), U8.7 (V_IO), U8.8 (VCC)
+5V: C4.1, C5.1, C6.1, C8.1, C10.1, C50.1, C51.1, D3.1 (K), L1.2, M1.5VA (+5.0VI), M1.5VB (+5.0VI), U3.1 (FB), U4.4 (EN), U4.6 (IN), U5.1 (IN), U5.3 (EN), U6.1 (IN), U6.3 (EN)
BOOT: R11.2, SW2.1, U1.5 (GPIO0)
BUCK_BST: C3.1, U3.6 (BST)
BUCK_EN: R1.2, R2.1, U3.2 (EN)
BUCK_SW: C3.2, L1.1, U3.5 (SW)
CHIP_PU: C34.1, R10.2, SW1.1, U1.4 (CHIP_PU)
D+: J1.A6 (Dp1), J1.B6 (Dp2), U2.3 (I/O2)
D-: J1.A7 (Dn1), J1.B7 (Dn2), U2.1 (I/O1)
DOCK1_EN: J3.5, U1.15 (GPIO10)
DOCK1_FLT: J3.9, R50.2, U1.11 (GPIO6)
DOCK1_ILM: J3.13, R54.1
DOCK1_ILM_A: C60.1, R54.2, U1.6 (GPIO1)
DOCK2_EN: J3.6, U1.16 (GPIO11)
DOCK2_FLT: J3.10, R51.2, U1.12 (GPIO7)
DOCK2_ILM: J3.14, R55.1
DOCK2_ILM_A: C61.1, R55.2, U1.7 (GPIO2)
DOCK3_EN: J3.7, U1.17 (GPIO12)
DOCK3_FLT: J3.11, R52.2, U1.13 (GPIO8)
DOCK3_ILM: J3.15, R56.1
DOCK3_ILM_A: C62.1, R56.2, U1.9 (GPIO4)
DOCK4_EN: J3.8, U1.18 (GPIO13)
DOCK4_FLT: J3.12, R53.2, U1.14 (GPIO9)
DOCK4_ILM: J3.16, R57.1
DOCK4_ILM_A: C63.1, R57.2, U1.10 (GPIO5)
ESP_ANT: C37.1, R12.2, U1.1 (LNA_IN)
ESP_ANT_UFL: C38.1, J2.1 (SIG), R12.1
ETH_RCT: C54.1, J6.5 (RCT), R41.2
ETH_RXN: J6.6 (RD-), M1.34 (P0RN)
ETH_RXP: J6.4 (RD+), M1.33 (P0RP)
ETH_TCT: C53.1, J6.2 (TCT), R40.2
ETH_TXN: J6.3 (TD-), M1.36 (P0TN)
ETH_TXP: J6.1 (TD+), M1.35 (P0TP)
F9P_ANT_FB: FB1.2, L4.1
F9P_ANT_PWR: C43.1, FB1.1, R30.2
F9P_RESET_N: U1.27 (GPIO21), U7.49 (~RESET)
F9P_RF: J4.1 (In), L4.2, U7.2 (RF_IN)
F9P_RXD: U1.23 (GPIO17), U7.43 (RXD/SPI_MOSI)
F9P_RXD2: J8.3, U7.26 (RXD2)
F9P_SAFEBOOT_N: TP1.1, U7.50 (~SAFEBOOT)
F9P_TP: R31.1, U7.53 (TIMEPULSE)
F9P_TP_A: D6.2 (A), R31.2
F9P_TXD: U1.24 (GPIO18), U7.42 (TXD/SPI_MISO)
F9P_TXD2: J8.2, U7.27 (TXD2)
F9P_VCC_RF: R30.1, U7.7 (VCC_RF)
GND: C1.2, C2.2, C4.2, C5.2, C6.2, C7.2, C8.2, C9.2, C10.2, C11.2, C20.2, C21.2, C22.2, C23.2, C24.2, C25.2, C26.2, C27.2, C28.2, C29.2, C30.2, C31.2, C32.2, C33.2, C34.2, C35.2, C36.2, C37.2, C38.2, C39.2, C40.2, C41.2, C42.2, C43.2, C44.2, C45.2, C46.2, C50.2, C51.2, C53.2, C54.2, C60.2, C61.2, C62.2, C63.2, D2.1 (K), D4.1 (K), D5.1 (K), D6.1 (K), J1.13 (EH), J1.14 (EH), J1.A1B12 (GND), J1.B1A12 (GND), J2.2 (GND), J2.3 (GND), J3.3, J3.4, J3.17, J3.18, J3.19, J3.20, J4.2 (Ext), J5.2 (GND), J5.3 (GND), J6.8, J6.SH, J7.1, J8.1, J9.6, M1.GA (GND), M1.GB (GND), M1.GC (GND), M1.GD (GND), R2.2, R13.2, R14.2, SW1.2, SW2.2, U1.57 (GND), U2.2 (GND), U3.4 (GND), U4.3 (GND), U4.7 (EP), U5.2 (GND), U6.2 (GND), U7.1 (GND), U7.3 (GND), U7.12 (GND), U7.14 (GND), U7.32 (GND), U7.37 (GND), U7.38 (V_USB), U7.41 (GND), U7.48 (GND), U7.55 (GND), U8.1 (GND), U8.10 (GND), U8.12 (GND), X1.2, X1.4
LED_G: R16.1, U1.45 (MTDO)
LED_G_A: D5.2 (A), R16.2
LED_PWR: D2.2 (A), R3.2
LED_Y: R15.1, U1.44 (MTCK)
LED_Y_A: D4.2 (A), R15.2
M10_RF: J5.1 (SIG), L5.2, U8.11 (RF_IN)
M10_RXD: U1.21 (XTAL_32K_P), U8.3 (RXD)
M10_TXD: U1.22 (XTAL_32K_N), U8.2 (TXD)
M10_VCC_RF: C46.1, L5.1, U8.14 (VCC_RF)
SPARE1: J9.2, U1.38 (GPIO33)
SPARE2: J9.3, U1.39 (GPIO34)
SPARE3: J9.4, U1.40 (GPIO35)
SPARE4: J9.5, U1.41 (GPIO36)
USB_CC1: J1.A5 (CC1), R13.1
USB_CC2: J1.B5 (CC2), R14.1
USB_DN: U1.25 (GPIO19/USB_D-), U2.6 (I/O1)
USB_DP: U1.26 (GPIO20/USB_D+), U2.4 (I/O2)
VBUS: C39.1, D3.2 (A), J1.A4B9 (VBUS), J1.B4A9 (VBUS), U2.5 (VBUS)
VDD3P3: C20.1, L2.2, U1.2 (VDD3P3), U1.3 (VDD3P3)
VDD_SPI: C32.1, C33.1, U1.29 (VDD_SPI)
VIN_SYS: C1.1, C2.1, J3.1, J3.2, R1.1, U3.3 (VIN)
VOC_CON_RX: J7.2, M1.40 (RXD2)
VOC_CON_TX: J7.3, M1.42 (TXD2)
VOC_RST: M1.138 (RST), U1.19 (GPIO14)
VOC_RXD1: M1.148 (RXD1), U1.49 (U0TXD)
VOC_TXD1: M1.147 (TXD1), U1.50 (U0RXD)
XTAL_N: C36.1, U1.53 (XTAL_N), X1.3 (OSC2)
XTAL_P: C35.1, L3.2, X1.1 (OSC1)
XTAL_P_CHIP: L3.1, U1.54 (XTAL_P)
