pranavs41/tar-team1-hardware/pcb/ground-station/power/ground-station-power.kicad_sch

## KiCad design pcb/ground-station/power/ground-station-power.kicad_sch (2026-10-29)

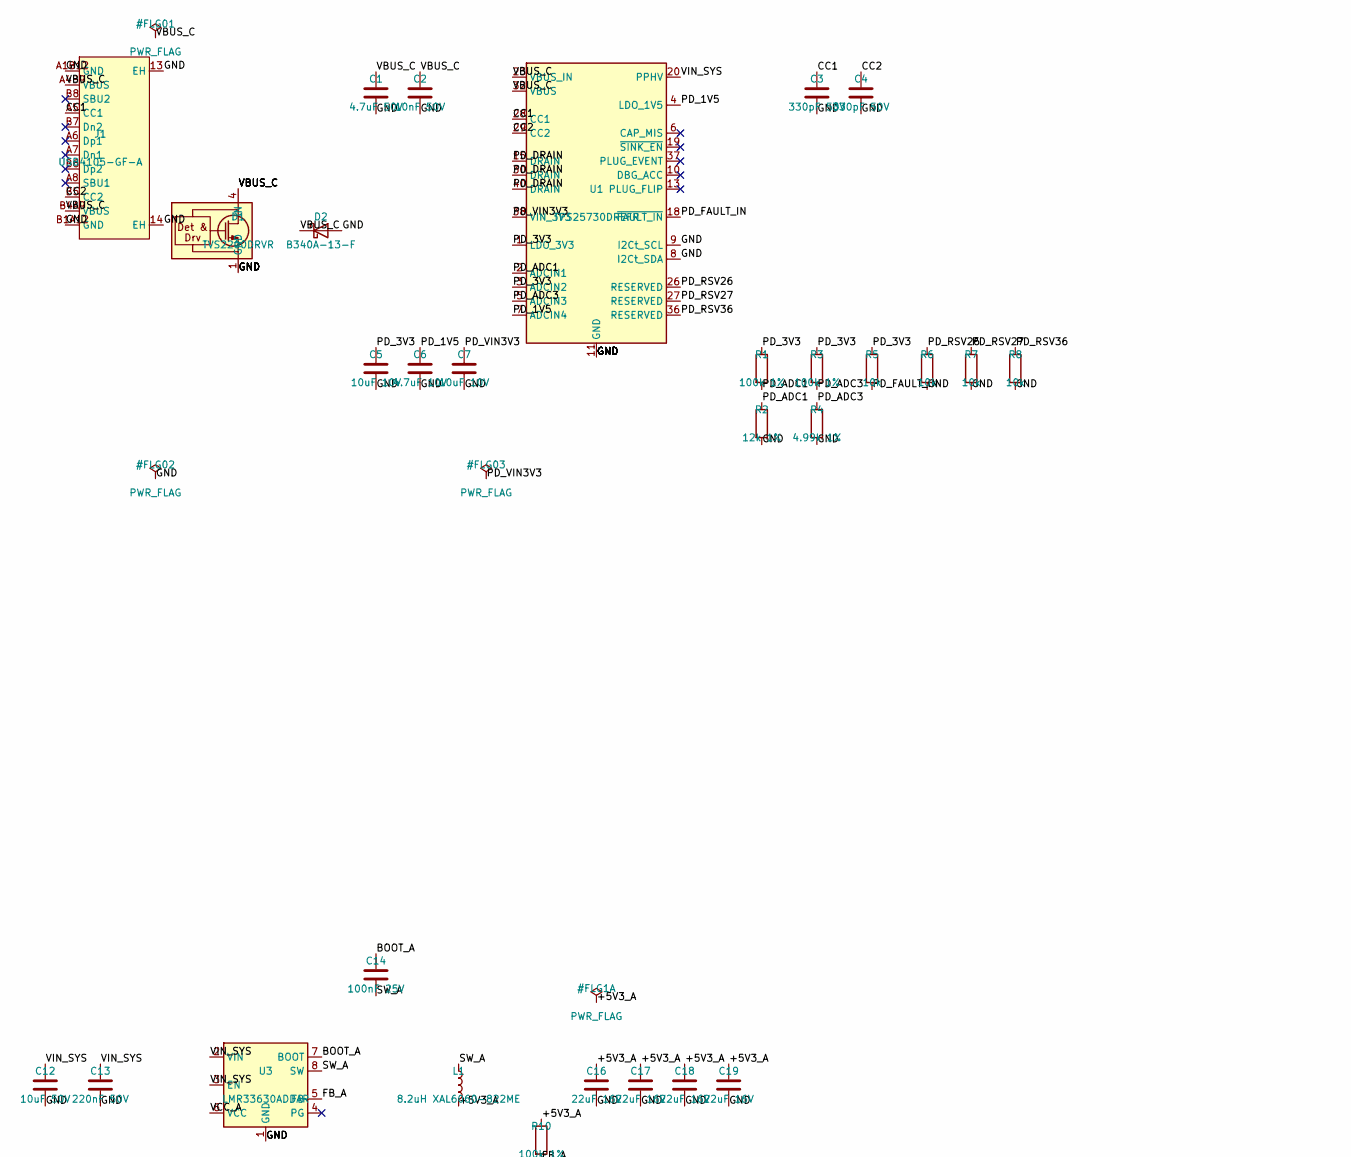
[picture p17: schematic ground-station-power.kicad_sch, part in row 1, column 1]

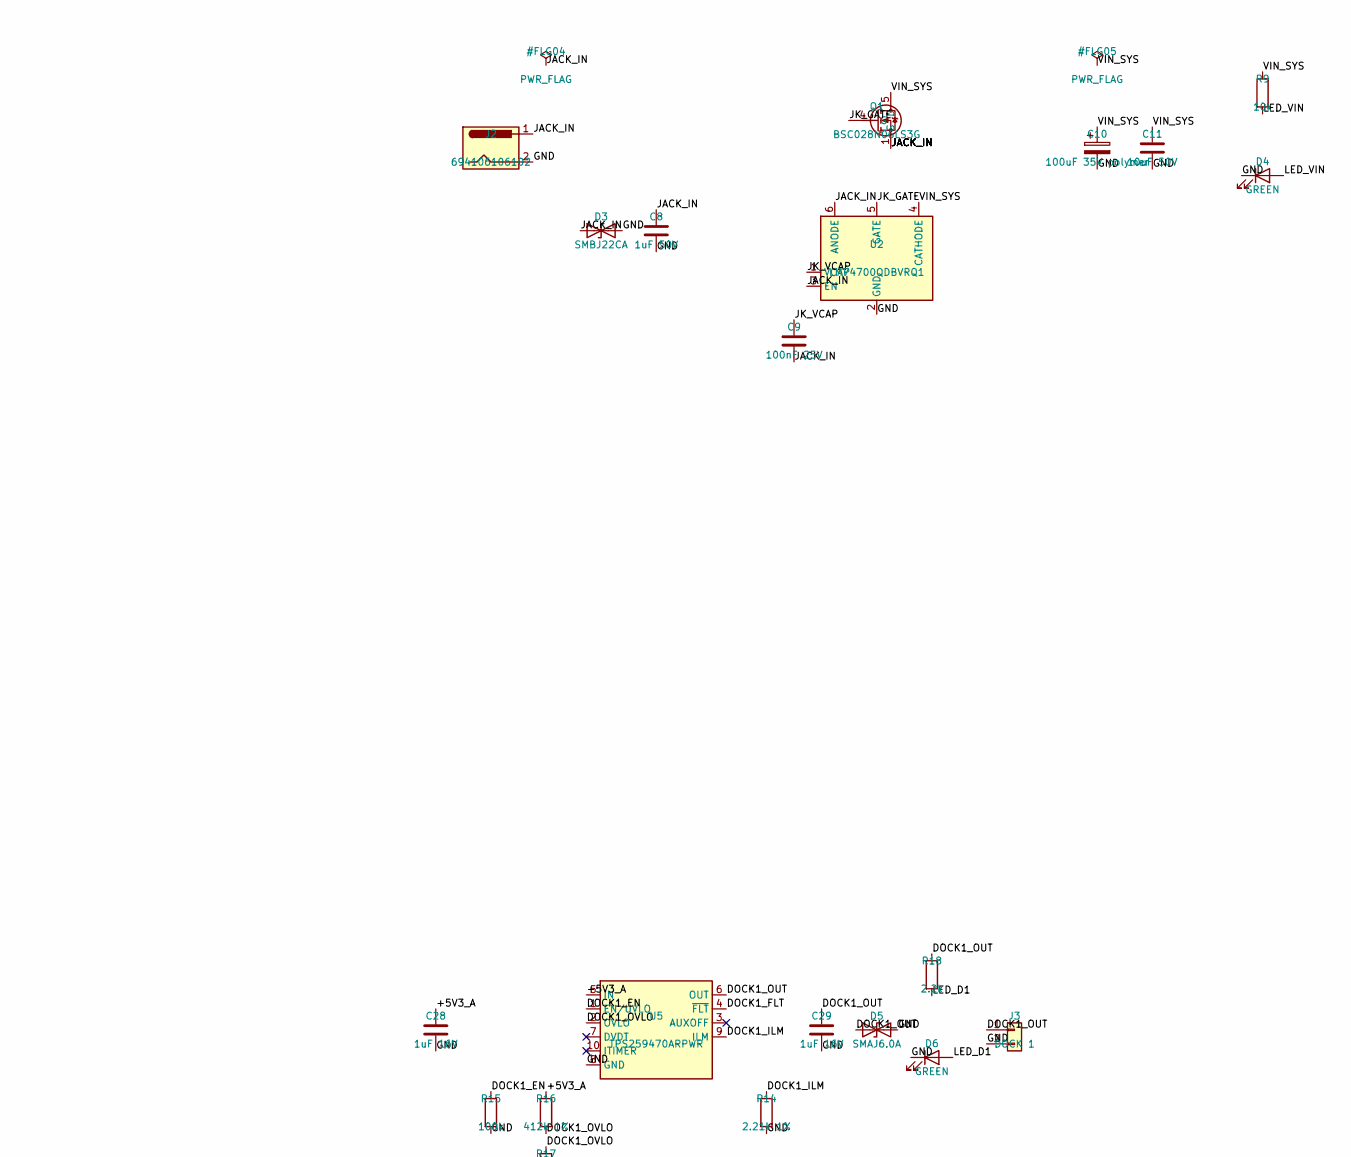
[picture p18: schematic ground-station-power.kicad_sch, part in row 1, column 2]

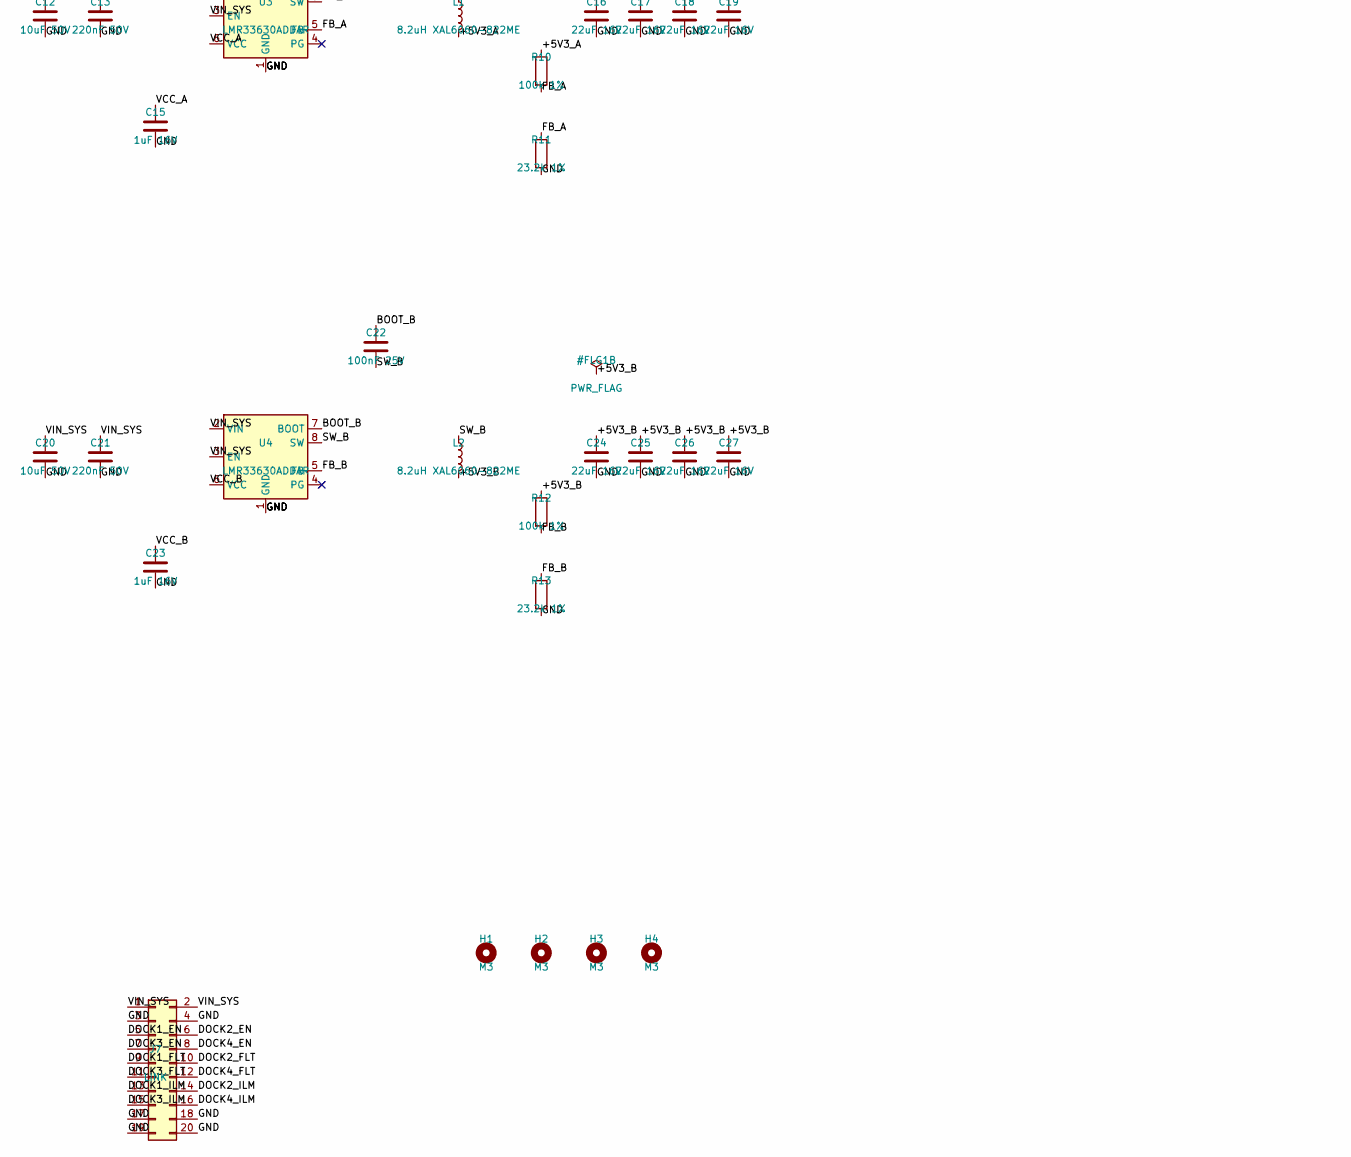
[picture p19: schematic ground-station-power.kicad_sch, part in row 2, column 1]

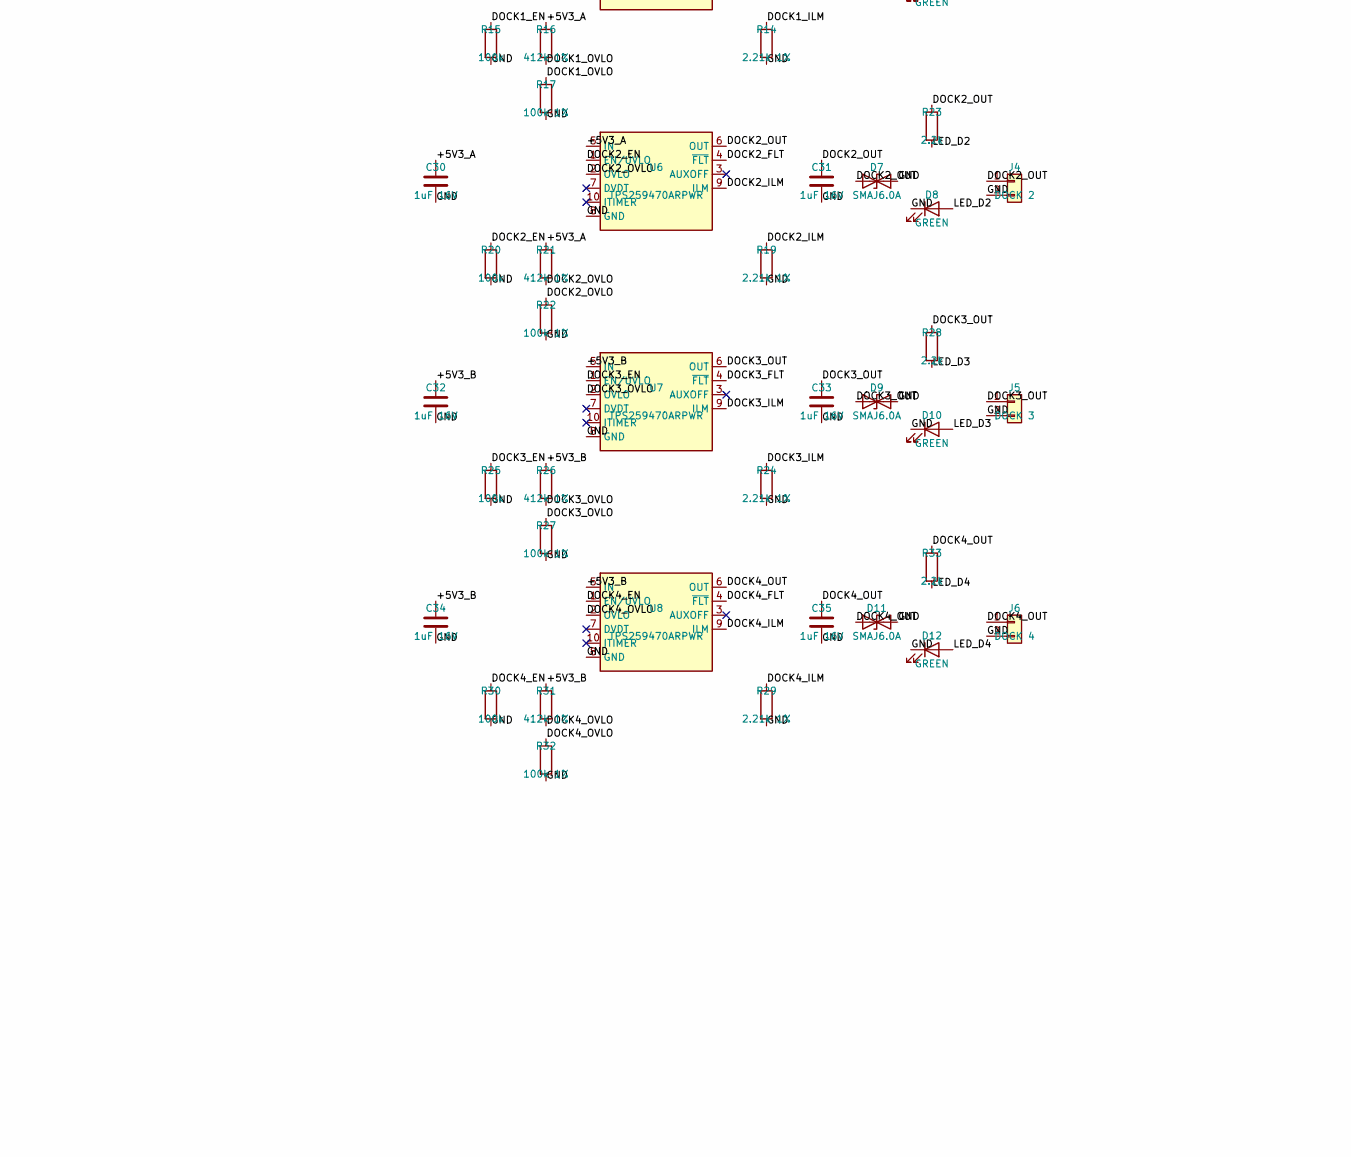
[picture p20: schematic ground-station-power.kicad_sch, part in row 2, column 2]

Parts:
C1: 4.7uF 50V; C_1206_3216Metric
C2: 10nF 50V; C_0402_1005Metric
C3, C4: 330pF 50V; C_0402_1005Metric
C5, C7: 10uF 10V; C_0603_1608Metric
C6: 4.7uF 10V; C_0603_1608Metric
C8: 1uF 50V; C_0805_2012Metric
C9, C14, C22: 100nF 25V; C_0402_1005Metric
C10: 100uF 35V polymer; CP_Elec_8x10
C11, C12, C20: 10uF 50V; C_1210_3225Metric
C13, C21: 220nF 50V; C_0603_1608Metric
C15, C23, C28, C29, C30, C31, C32, C33, C34, C35: 1uF 16V; C_0402_1005Metric
C16, C17, C18, C19, C24, C25, C26, C27: 22uF 16V; C_1210_3225Metric
D1: TVS2200DRVR; WSON-6-1EP_2x2mm_P0.65mm_EP1x1.6mm
D2: B340A-13-F; D_SMA
D3: SMBJ22CA; D_SMB
D4, D6, D8, D10, D12: GREEN; LED_0603_1608Metric
D5, D7, D9, D11: SMAJ6.0A; D_SMA
H1, H2, H3, H4: M3; MountingHole_3.2mm_M3
J1: USB4105-GF-A; USB-C-SMD_TYPE-C-16PIN-2MD-073
J2: 694106106102; BarrelJack_Wuerth_694106106102_2.0x5.5mm
J3: DOCK 1; JST_XH_B2B-XH-A_1x02_P2.50mm_Vertical
J4: DOCK 2; JST_XH_B2B-XH-A_1x02_P2.50mm_Vertical
J5: DOCK 3; JST_XH_B2B-XH-A_1x02_P2.50mm_Vertical
J6: DOCK 4; JST_XH_B2B-XH-A_1x02_P2.50mm_Vertical
J7: LINK; IDC-Header_2x10_P2.54mm_Vertical
L1, L2: 8.2uH XAL6060-822ME; L_Coilcraft_XAL6060-XXX
Q1: BSC028N06LS3G; TDSON-8-1
R1, R3, R10, R12, R17, R22, R27, R32: 100k 1%; R_0402_1005Metric
R2: 12k 1%; R_0402_1005Metric
R4: 4.99k 1%; R_0402_1005Metric
R5, R6, R7, R8: 10k; R_0402_1005Metric
R9: 10k; R_0603_1608Metric
R11, R13: 23.2k 1%; R_0402_1005Metric
R14, R19, R24, R29: 2.21k 1%; R_0402_1005Metric
R15, R20, R25, R30: 100k; R_0402_1005Metric
R16, R21, R26, R31: 412k 1%; R_0402_1005Metric
R18, R23, R28, R33: 2.2k; R_0402_1005Metric
U1: TPS25730DREFR; Texas_REF0038A_WQFN-38-2EP_6x4mm_P0.4
U2: LM74700QDBVRQ1; SOT-23-6
U3, U4: LMR33630ADDAR; Texas_HSOP-8-1EP_3.9x4.9mm_P1.27mm_ThermalVias
U5, U6, U7, U8: TPS259470ARPWR; Texas_RPW0010A_VQFN-HR-10_2x2mm

Connections:
+5V3_A: C16.1, C17.1, C18.1, C19.1, C28.1, C30.1, L1.2, R10.1, R16.1, R21.1, U5.5 (IN), U6.5 (IN)
+5V3_B: C24.1, C25.1, C26.1, C27.1, C32.1, C34.1, L2.2, R12.1, R26.1, R31.1, U7.5 (IN), U8.5 (IN)
BOOT_A: C14.1, U3.7 (BOOT)
BOOT_B: C22.1, U4.7 (BOOT)
CC1: C3.1, J1.A5 (CC1), U1.28 (CC1)
CC2: C4.1, J1.B5 (CC2), U1.29 (CC2)
DOCK1_EN: J7.5, R15.1, U5.1 (EN/UVLO)
DOCK1_FLT: J7.9, U5.4 (~FLT)
DOCK1_ILM: J7.13, R14.1, U5.9 (ILM)
DOCK1_OUT: C29.1, D5.1 (A1), J3.1, R18.1, U5.6 (OUT)
DOCK1_OVLO: R16.2, R17.1, U5.2 (OVLO)
DOCK2_EN: J7.6, R20.1, U6.1 (EN/UVLO)
DOCK2_FLT: J7.10, U6.4 (~FLT)
DOCK2_ILM: J7.14, R19.1, U6.9 (ILM)
DOCK2_OUT: C31.1, D7.1 (A1), J4.1, R23.1, U6.6 (OUT)
DOCK2_OVLO: R21.2, R22.1, U6.2 (OVLO)
DOCK3_EN: J7.7, R25.1, U7.1 (EN/UVLO)
DOCK3_FLT: J7.11, U7.4 (~FLT)
DOCK3_ILM: J7.15, R24.1, U7.9 (ILM)
DOCK3_OUT: C33.1, D9.1 (A1), J5.1, R28.1, U7.6 (OUT)
DOCK3_OVLO: R26.2, R27.1, U7.2 (OVLO)
DOCK4_EN: J7.8, R30.1, U8.1 (EN/UVLO)
DOCK4_FLT: J7.12, U8.4 (~FLT)
DOCK4_ILM: J7.16, R29.1, U8.9 (ILM)
DOCK4_OUT: C35.1, D11.1 (A1), J6.1, R33.1, U8.6 (OUT)
DOCK4_OVLO: R31.2, R32.1, U8.2 (OVLO)
FB_A: R10.2, R11.1, U3.5 (FB)
FB_B: R12.2, R13.1, U4.5 (FB)
GND: C1.2, C2.2, C3.2, C4.2, C5.2, C6.2, C7.2, C8.2, C10.2, C11.2, C12.2, C13.2, C15.2, C16.2, C17.2, C18.2, C19.2, C20.2, C21.2, C23.2, C24.2, C25.2, C26.2, C27.2, C28.2, C29.2, C30.2, C31.2, C32.2, C33.2, C34.2, C35.2, D1.1 (GND), D1.2 (GND), D1.3 (GND), D1.7 (GND), D2.2 (A), D3.2 (A2), D4.1 (K), D5.2 (A2), D6.1 (K), D7.2 (A2), D8.1 (K), D9.2 (A2), D10.1 (K), D11.2 (A2), D12.1 (K), J1.13 (EH), J1.14 (EH), J1.A1B12 (GND), J1.B1A12 (GND), J2.2, J3.2, J4.2, J5.2, J6.2, J7.3, J7.4, J7.17, J7.18, J7.19, J7.20, R2.2, R4.2, R6.2, R7.2, R8.2, R11.2, R13.2, R14.2, R15.2, R17.2, R19.2, R20.2, R22.2, R24.2, R25.2, R27.2, R29.2, R30.2, R32.2, U1.8 (I2Ct_SDA), U1.9 (I2Ct_SCL), U1.11 (GND), U1.12 (GND), U1.14 (GND), U1.16 (GND), U1.17 (GND), U1.31 (GND), U1.34 (GND), U1.39 (GND), U2.2 (GND), U3.1 (GND), U3.9 (GND), U4.1 (GND), U4.9 (GND), U5.8 (GND), U6.8 (GND), U7.8 (GND), U8.8 (GND)
JACK_IN: C8.1, C9.2, D3.1 (A1), J2.1, Q1.1 (S), Q1.2 (S), Q1.3 (S), U2.3 (EN), U2.6 (ANODE)
JK_GATE: Q1.4 (G), U2.5 (GATE)
JK_VCAP: C9.1, U2.1 (VCAP)
LED_D1: D6.2 (A), R18.2
LED_D2: D8.2 (A), R23.2
LED_D3: D10.2 (A), R28.2
LED_D4: D12.2 (A), R33.2
LED_VIN: D4.2 (A), R9.2
PD_1V5: C6.1, U1.4 (LDO_1V5), U1.7 (ADCIN4)
PD_3V3: C5.1, R1.1, R3.1, R5.1, U1.1 (LDO_3V3), U1.3 (ADCIN2)
PD_ADC1: R1.2, R2.1, U1.2 (ADCIN1)
PD_ADC3: R3.2, R4.1, U1.5 (ADCIN3)
PD_DRAIN: U1.15 (DRAIN), U1.30 (DRAIN), U1.40 (DRAIN)
PD_FAULT_IN: R5.2, U1.18 (~FAULT_IN)
PD_RSV26: R6.1, U1.26 (RESERVED)
PD_RSV27: R7.1, U1.27 (RESERVED)
PD_RSV36: R8.1, U1.36 (RESERVED)
PD_VIN3V3: C7.1, U1.38 (VIN_3V3)
SW_A: C14.2, L1.1, U3.8 (SW)
SW_B: C22.2, L2.1, U4.8 (SW)
VBUS_C: C1.1, C2.1, D1.4 (IN), D1.5 (IN), D1.6 (IN), D2.1 (K), J1.A4B9 (VBUS), J1.B4A9 (VBUS), U1.23 (VBUS_IN), U1.32 (VBUS)
VCC_A: C15.1, U3.6 (VCC)
VCC_B: C23.1, U4.6 (VCC)
VIN_SYS: C10.1, C11.1, C12.1, C13.1, C20.1, C21.1, J7.1, J7.2, Q1.5 (D), R9.1, U1.20 (PPHV), U2.4 (CATHODE), U3.2 (VIN), U3.3 (EN), U4.2 (VIN), U4.3 (EN)
