pranavs41/tar-team1-hardware/(commit log)

2026-09-27 Add FC parts library: symbols, footprints and STEP models from LCSC
    3D model paths use ${KIPRJMOD} so the library works on any teammate's machine.
2026-09-27 Add network drone FC KiCad project: 27x27 mm, 4-layer, 20x20 M2 ESC holes
2026-09-27 Switch MCU to bare ESP32-S3FN8 chip with 40 MHz crystal
    Team rule is bare chips only, so the MINI-1U module stays in the library only as a fallback.
2026-09-27 Add 2.0 nH VDD3P3 inductor and in-stock alt for the 4-pin GH port
    Genuine JST SM04B-GHS-TB had 6 units at LCSC on 2026-09-26.
2026-09-27 Ignore KiCad autosave index
2026-09-27 Grow board to 36x36 mm so all parts fit on one side for hot-plate reflow
    Keeps the 20x20 M2 holes to stack on the smaller ESC.
2026-09-27 Switch USB-C to generic 16-pin connector ($0.07 vs $1.03)
2026-09-27 Schematic: complete MCU box
    ESP32-S3FN8 with decoupling and VDD3P3 LC filter, EN RC reset, BOOT button,
    40 MHz crystal, RF pi network to U.FL (shunts DNP), USB-C with ESD and
    VBUS diode, status LEDs, UART test pads, and labels on all signal pins.
2026-09-27 Set up repo layout: design docs, pin map, bring-up checklist, production and mechanical folders
2026-09-27 Use SMAJ18A TVS: SMAJ15A starts conducting below a full 4S pack (16.8 V)
2026-09-27 Schematic: power box - SMAJ18A TVS, AP63205 5 V buck, dual 3.3 V LDOs
    TLV75733 feeds the ESP32 rail (+3V3); low-noise TPS7A2033 feeds a separate
    +3V3_SENS rail so radio TX bursts stay out of the IMU and barometer supply.
2026-09-27 Add circuit guide: how the MCU, USB and power circuits work and why
2026-09-27 Schematic: battery sense divider (VBAT/11 to ADC1) and rail test points
2026-09-27 Schematic: PWR_FLAGs on all rails; power box complete, ERC power errors cleared
2026-09-27 Add schematic PDF export (MCU, USB, power boxes) for viewing on GitHub
2026-09-27 Add electrical/DESIGN.md: requirements, block diagram, parts, power tree, board layout plan
2026-09-27 Rewrite circuit guide in plain language
2026-09-27 Move KiCad project into electrical/pcb/network-drone-fc
    Library and 3D model paths are relative to the project, so nothing else changes;
    ERC and netlist are identical before and after.
2026-09-27 Drop BNO085 and its 32 kHz crystal from the parts library
    The ICM-42688-P covers the rate loop and orientation fusion runs in ESP32
    firmware, as on Betaflight/PX4 boards, so the BNO085 only added cost (~$20),
    a dozen parts and five ESP32 pins.
2026-09-27 Remove BNO085 from design doc, pin map, parts list and docs; log the decision
2026-09-27 Remove leftover dashes from datasheet links and pin map
2026-10-01 Plan charging-board port: DOCK_DET on GPIO18, AUX_ADC on GPIO8 (ADC1)
    ESC telemetry moves from GPIO8 to GPIO17 (freed by the BNO085 removal) so the
    charging board gets an ADC1 pin; ADC2 is unusable while Wi-Fi runs.
2026-10-01 Schematic: remove BNO085 labels, move ESC_TELEM to GPIO17, add DOCK_DET and AUX_ADC labels
2026-10-01 Schematic: wire ICM-42688-P IMU on SPI with INT1/INT2 and CS pull-up
    BMP581 and MAX-M10S are placed but not wired yet.
2026-10-01 Circuit guide: add sensors page, starting with the ICM-42688-P
2026-10-01 Library: mark all tar_fc symbol pins passive so ERC stops flagging pin-type mismatches
2026-10-01 Schematic: complete sensors and connectors boxes, assign all footprints
    BMP581 on I2C (CSB high, SDO low, 4.7k pull-ups), MAX-M10S GPS with U.FL and
    a DNP bias-T for an active antenna, ESC JST-SH 8 (Betaflight pin order), I2C
    and UART JST-GH ports (Dronecode order), charging-board port (DOCK_DET,
    AUX_ADC). ESP32 power-pin decoupling redrawn as one rail with the LC filter,
    IMU VDDIO capacitor moved off the pin-7 ground stub. ERC: 0 errors, 0 warnings.
2026-10-01 PCB: place every part on the 36x36 board, nets from the schematic, rules set
    All parts on the top side per the floorplan: IMU centre, ESP32 right with its
    decoupling column and crystal, GPS top with its U.FL at the corner, buck above
    the ESC connector, ports on the edges, test pads on the bottom. Plain NPTH M2
    holes. DRC: no clearance, edge or courtyard errors; routing still to do.
2026-10-01 Circuit guide: barometer, GPS and connectors pages
2026-10-01 Design doc: board layout as placed, connector and mounting-hole decisions, bias-T inductor part
2026-10-01 Project settings: board design rules saved by KiCad
2026-10-01 Net classes: Battery 0.8 mm, Power 0.5 mm, RF 0.3 mm, USB pair 0.2/0.15 mm
2026-10-01 Pads instead of buttons, twelve more test points, 3 mm hole keep-out
    RESET/BOOT become JP1/JP2 solder-jumper pad pairs on the bottom. TP7-TP18 bring
    the IMU SPI bus, I2C, GPS UART, ESC telemetry and the spare UART to bottom-side
    pads. The spare UART connector J6 is dropped: with 3 mm clear around each hole
    for grommets, the board has one connector slot per edge. Charging port moves to
    the top right. DRC: no copper errors.
2026-10-01 Docs: test pads, recovery pad pairs, grommet keep-out and the dropped UART port
2026-10-01 PCB: GND planes on In1 and bottom; autoroute the signal and 3.3 V nets with Freerouting
    Freerouting 2.4.1 ran headless on a DSN with the critical nets removed, so the
    antenna paths, crystal, USB pair, buck loop (VBAT, SW, BST, +5V) and the VDD3P3
    filter node are untouched for hand routing. 149 of 160 nets routed; MOTOR1-4,
    ESC_CUR, SPI_MOSI, I2C_SDA/SCL, one +3V3 and one +3V3_SENS link, and the BOOT
    pad still open. Two RF-class clearance nits (0.15/0.18 mm) sit next to the
    antenna pads and go away when those nets are routed by hand.
2026-10-01 Project settings saved by KiCad
2026-10-01 PCB: remove the autoroute; keep placement and GND planes for hand routing
2026-10-01 PCB: tighten the buck loop (L2 flipped toward SW, C18 at the inductor output), fix the charging port orientation
    The earlier text-level rotation double-rotated J7, L2 and C18 (KiCad stores pad
    positions unrotated and applies the footprint angle on load). Corrected, so the
    charging port's cable mouth now faces the top edge.
2026-10-01 PCB: charging port clear of the corner arc
2026-10-01 PCB: charging port 0.3 mm from the corner arc
2026-10-01 PCB: 3 mm strip on top so the charging port clears the H2 grommet; every top part now 3 mm from the holes
2026-10-02 PCB: mounting holes 3.2 mm for the M3 ESC stack
2026-10-02 PCB: hole courtyards trimmed to the 3 mm keep-out
2026-10-02 PCB: placement reworked for routing; antenna, GPS feed, crystal, USB and buck routed by hand
2026-10-02 Schematic: ESP32 re-pinned for routing; INT2, R2 and eleven test pads dropped
    Motors on GPIO11/13/16/6, ESC telemetry GPIO10, battery sense GPIO4, dock detect GPIO9, GPS UART GPIO18/36, IMU SPI on GPIO33/34/35/47/48, I2C on GPIO37/38, LEDs on GPIO39/40. The IMU's INT2/FSYNC pin is left open, the 0 ohm XTAL_P jumper R2 is gone, and only seven test pads remain (UART0, the four rails, I2C SCL). ERC 0 errors, 0 warnings.
2026-10-02 PCB: fully routed, GND and +3V3 planes, 160 vias, DRC clean
    Antenna, GPS feed, crystal, USB, buck and IMU SPI by hand; the rest on a 0.1 mm grid router kept to two signal layers. In1 is solid GND, In2 is solid +3V3, top and bottom carry GND fills. Test pads sit on vias of their nets. DRC: 0 errors, 0 unconnected; only silkscreen warnings remain.
2026-10-02 Schematic: drop the spare-UART note from the connector sheet
2026-10-02 Docs: pin map, stackup, test pads and decisions brought in line with the routed board
2026-10-02 PCB: straighten the router's staircase tracks (999 segments down to 544)
    Each chain of grid steps is replaced by the fewest straight or 45 degree segments that still clear every other item. Same vias, same paths, DRC still 0 errors.
2026-10-02 PCB: shorten Green, ICM_CS pull-up and GPS_TX (45, 31 and 27 mm down to 25, 10 and 20 mm)
    Each net was ripped up and rerouted with everything else fixed in place and vias priced cheaply. The old Green run along the west edge had been walling off the CS pull-up. 158 vias, DRC 0 errors.
2026-10-02 Docs: power budget, regulator heat, copper and battery-sag check with the model behind it
2026-10-02 Docs: power tree checked against SpeedyBee, Betaflight F4, Pixhawk 6C and Espressif guidance; ESC bulk capacitor required
2026-10-03 Schematic: C35, 100 uF 25 V polymer tantalum bulk capacitor on VBAT
2026-10-03 PCB: C35 on the bottom side at the lower-left corner, tied to the VBAT test-point via; DRC clean
2026-10-03 Docs: bulk capacitor C35 in the power guide, BOM, bring-up and decisions
2026-10-03 Schematic: U4 to TLV75733PDRVR (WSON-6 with thermal pad); C16 to 1206
2026-10-03 PCB: U4 in the WSON-6 footprint with a via under its pad; C16 as a 1206 with the crystal moved up 0.6 mm; DRC clean
2026-10-03 Docs: U4 package and C16 size changes in the power guide, BOM, budget and decisions
2026-10-03 PCB: second optimisation pass; I2C_SCL 38 to 33 mm and 7 to 4 vias, ESC_CUR and MOTOR4 shortened, RESET pair one via fewer; 156 vias, DRC clean
2026-10-03 PCB: second straightening pass; corner redraws and 111 stubs hidden inside pads removed (544 to 432 segments), DRC clean
2026-10-09 PCB: hand reroutes (ESC telemetry and nearby tracks)
2026-10-09 Schematic: split the battery wire where C35 joins so the buck input is on VBAT again
    A junction on an unbroken wire does not connect in KiCad. Since C35 was added the schematic had C16, D5 and the buck's VIN/EN on their own net. The board was correct throughout.
2026-10-09 Schematic: J5 becomes a 5 V sensor port (TF-Luna); J6 radio port added (5 V UART for the VoCore2)
    J6 TX and RX share GPIO2 and GPIO10 with J4 pins 3 and 4. ERC 0 errors, 0 warnings.
2026-10-09 PCB: J6 radio port in the bottom-right corner, J5 power pin on +5V, own 5 V branch from the buck output
    159 vias. DRC 0 errors; one new courtyard warning where J6's outline is 0.2 mm inside the H3 keep-out (pads and body clear it). Schematic and board match on all 296 pins.
2026-10-09 Docs: sensor port, radio port, shared ESC pins, 5 V budget with the TF-Luna and VoCore2
2026-10-09 Repo: top-level folders for pcb, schematics, cad, docs and tools
    The KiCad project moves from electrical/pcb to pcb, the schematic PDF to schematics, the board render to cad, and the documents to docs. Links inside the documents follow.
2026-10-09 Docs: one-page hardware reference with every connector, pin, voltage and limit
2026-10-09 CAD: assembled board as a STEP model, bottom-side render, frame file links
2026-10-09 PCB: chamfer the 16 right-angle track corners into 45 degree bends
    USB pair, crystal, IMU interrupt, CC2 and a few power links. No corner on the board is now 100 degrees or sharper. DRC 0 errors; schematic and board still match on all 296 pins.
2026-10-11 Tasks: owners, checklists, interfaces between each person's work, and the charging concept
2026-10-11 Docs: frame test plan (bending, twist, drop, tied-down throttle, vibration)
2026-10-11 Docs: PCB test plan in three stages, with the checks still open before ordering
2026-10-11 Tasks: test steps added for the flight controller and the frame, linked to the two test plans
2026-10-11 PCB: ground via moved clear of the USB socket's slot; footprint library links and unused-pin net names synced with the schematic
    The via was 0.20 mm from the slot wall and is now 0.26 mm (fab minimum 0.25). The rest is bookkeeping with no copper change: KiCad's schematic parity check drops from 140 items to 2, both the USB socket's grounded locating pegs.
2026-10-11 Docs: results of the pre-order checks (pinout audit, fab limits, antenna impedance, circuit calculations)
2026-10-11 Update 2S LiPo battery entry with product link
    Updated the link for the 2S LiPo battery to a specific product on Amazon.
2026-10-11 Schematic: C16 footprint field set to 1206 to match the board
    The board has carried the 1206 since the capacitor was enlarged; the schematic's footprint field still named the 0805. No copper change.
2026-10-11 Schematic: charging port J7 grows to 7 pins (battery, GND, I2C, power good, charge status, charge disable); landing sensor port J8 added; I2C pull-ups to 2.2k
2026-10-11 PCB: 7-pin JST-SH charging connector and top-entry landing sensor port placed and routed; GPIO7 drives charge disable
2026-10-11 Schematic PDF and STEP model regenerated for the charging and landing sensor ports
2026-10-11 Docs: pin reference and circuit guides updated for the 7-pin charging port and the landing sensor port
2026-10-11 Docs: power budget, check results and decision log updated for the second sensor and the charging port
2026-10-11 Docs: charging board page with its plan, parts, open checks and the 7-pin link to the flight controller
2026-10-11 Parts list: 1000 mAh battery, second distance sensor, new connectors and the charging board; total now about 284 dollars
2026-10-11 Tasks: charging board pinout, landing sensor and larger battery added to the frame and charging sections
2026-10-11 Board pictures re-rendered with the new charging connector and landing sensor port
2026-10-13 Enhance 3D-printed frame entry with carbon fiber details
    Updated the 3D-printed frame entry to include a carbon fiber subframe link.
2026-10-13 Board setup: solder mask to copper clearance set to 0.005 mm
2026-10-13 USB-C footprint: mounting slots lengthened 0.4 mm to fit the GCT USB4105 socket, nearby tracks moved clear
2026-10-13 PCB: six tight spots opened up to pass a 0.127 mm spacing rule, ground via moved clear of the longer USB slot
2026-10-13 Parts list: green LED changed to a 2 V type, USB socket and spacing fixes marked done, gyro stock note
2026-10-13 Decision log, test results and LED note updated for the USB slot, spacing and green LED changes
2026-10-13 Tasks: USB slots, tight spots and green LED ticked off
2026-10-13 STEP model regenerated with the longer USB-C slots
2026-10-13 Board pictures re-rendered after the USB slot and spacing fixes
2026-10-13 Schematic: J4 relabelled to the ESC's pin order (GND, VBAT, motors 1 to 4, N, C), motor numbers moved between GPIOs
2026-10-13 PCB: J4 pads follow the ESC's pin order, four tracks rerouted at the connector
2026-10-13 Pin reference and connector guide updated for the new J4 order and motor pins
2026-10-13 Decision log, test plan and tasks: ESC pinout checked and J4 changed to match
2026-10-13 Schematic PDF and STEP model regenerated for the new J4 order
2026-10-13 Board pictures re-rendered after the J4 change
2026-10-13 ESC cable notes: N pad confirmed as no output from the seller's diagram, only the C wire needs pulling
2026-10-13 Parts list: ESC link added
2026-10-13 PCB: connector tab pads pulled back from the board edge and USB slot rings widened to meet OSH Park's limits
2026-10-13 Rev A order files: board, gerbers, stencil layer, DigiKey cart file and order sheet for OSH Park
2026-10-13 Docs: OSH Park chosen, antenna trace rechecked on its stack, parts list checked against every footprint
2026-10-13 Parts list: links to the two order sheets, VoCore link, battery plug warning
2026-10-13 Tasks: drone order sheet written, battery plug to settle
2026-10-13 Drone order sheet: VoCore store link, DigiKey links for the cable parts, M3 hardware kit added
2026-10-13 Rev A parts file: solder paste and flux added, note that parts can be ordered ahead of the boards
2026-10-13 Rev A parts files: solder paste and flux removed, the team already has them
2026-10-13 Rev A order sheet: solder paste and flux noted as already on hand
2026-10-13 Rev A parts files resized to one board; three bare boards are still ordered
2026-10-13 Full order sheet: battery already on hand, XT30 pair added to replace its JST plug
2026-10-13 Full order sheet: OVONIC 1100 mAh XT30 battery added, one XT30 for the ESC lead
2026-10-13 Battery changed to the OVONIC 2S 1100 mAh pack with an XT30 plug
2026-10-13 Battery notes updated for the OVONIC pack in the order sheet, parts list and tasks
2026-10-13 Compass: LIS3MDL breakout on the shared I2C cable, wiring and mounting notes
2026-10-13 Whole-drone power simulation script: rails, limits, motor model and a stepped flight
2026-10-13 Power budget: whole-drone simulation results and the two limits it found
2026-10-13 Gyro is bought from Newark: order sheets, DigiKey file and notes updated
2026-10-13 Order sheets: buck regulator from Mouser, sensor regulator from TI, J5 connector from LCSC, barometer on backorder
2026-10-13 Rev A: assembly pictures with every part's reference and pin 1 marked
2026-10-14 PCB: every track redrawn as horizontal, vertical and 45 degree runs
2026-10-14 Per-branch current check: traces each power path through the routed copper
2026-10-14 Rev A order files regenerated from the redrawn board
2026-10-14 Docs: track redraw and current check results
2026-10-14 PCB: mounting hole labels taken off the silkscreen, they overprinted J7 and nearby parts
2026-10-14 Rev A order files regenerated after the silkscreen change
2026-10-14 Board pictures re-rendered after the track redraw
2026-10-14 STEP model regenerated after the track redraw
2026-10-14 PCB: long diagonal tracks straightened into horizontal and vertical runs
2026-10-14 Board spacing rule raised to OSH Park's 0.127 mm
2026-10-14 Rev A order files regenerated from the straightened board
2026-10-14 Docs: track straightening and the new spacing rule
2026-10-14 Board pictures re-rendered after the track straightening
2026-10-14 STEP model regenerated after the track straightening
2026-10-14 Order sheets: charging board parts added as provisional; simple sheet rebuilt from the full one
2026-10-14 Tasks: Rishab to check the charging board parts on the order sheet
2026-10-14 Charging board parts checked against the BQ25887 datasheet: thermistor bias resistors added, input capacitors raised to 25 V
2026-10-14 Charging board page: datasheet answers for CD pull-down, I2C address, inductor and balancing resistor
2026-10-14 Charging board: LM66100 replaced by the 28 V LM73100 ideal diode with overvoltage cut-off
2026-10-14 Part values: SMAJ12A surge diode, 16 V buck output capacitors, crystal and diode labels match the parts ordered
2026-10-14 Datasheet audit: parts list, order sheets, 2S-only limit, sensor pin table, compass pull-ups and bring-up settings
2026-10-14 Schematic: 100 nF on VBUS at the USB protection chip, 10k pull-up on the boot pin (net BOOT)
2026-10-14 PCB: VBUS capacitor and boot pull-up on the bottom, antenna socket vias moved out from under J1 and J3, USB-C tab pads enlarged
2026-10-14 Parts list, decision log and order sheets: C36 and R16 added; battery cut-off deferred
2026-10-14 Rev A order files regenerated: new parts, bottom-side assembly notes, assembly pictures
2026-10-14 Schematic PDF regenerated
2026-10-14 Board pictures re-rendered with C36 and R16
2026-10-15 Battery cut-off on the 5 V regulator's enable pin
    R14 143k and R15 34k on the bottom set the AP63205 to turn on at about
    5.9 V and off at about 4.9 V. C16 is now 0805 so the battery reaches VIN
    through its own channel, and the green LED track moves left under the
    regulator to make room for the enable via.
2026-10-15 ESP32 supply capacitors at the pins' plane vias
    C37 (1 uF) on the VDDA pins 55 and 56, C38 (0.1 uF) on VDD3P3_CPU and
    C39 (0.1 uF) on VDD3P3_RTC, all on the bottom directly under each pin's
    via. The nearest capacitors before were 4 to 7 mm away.
2026-10-15 24 nH series inductor on the crystal's XTAL_P line
    Espressif's hardware design guide asks for a series part on XTAL_P,
    starting at 24 nH, to keep the crystal's harmonics out of the radio. L4
    sits in the existing vertical run beside the crystal. The chip side of
    the line is now the net XTAL_P_CHIP.
    The schematic symbols for R14, R15 and C37 to C39 also move out of the
    title block and a text note into empty space, with their labels drawn
    the right way round.
2026-10-15 Parts and order sheets: cut-off resistors, ESP32 supply capacitors, crystal inductor
    Adds R14 143k, R15 34k, L4 24 nH (Murata LQW15AN24NG00D) and two more
    0.1 uF and one more 1 uF. C16 is now the 0805 TDK C2012X5R1E106K125AB;
    Murata's 0805 equivalents are out of stock at DigiKey until November.
    The order notes list the eight bottom-side parts to hand-solder.
2026-10-15 Docs: battery cut-off, ESP32 supply capacitors, crystal inductor
    Circuit write-ups explain each change, the decision log records them
    and why the antenna match and USB back-feed stay as they are, and
    bring-up gains a bench test of the cut-off thresholds.
2026-10-15 Rev A order files regenerated: gerbers, stencil, board copy, schematic PDF, assembly pictures
2026-10-15 Board pictures re-rendered with the cut-off, supply capacitors and crystal inductor
2026-10-15 STEP model regenerated with the cut-off, supply capacitors and crystal inductor
2026-10-15 Charging board PMID and BAT capacitors: out-of-stock Murata swapped for the TDK part used as C16
2026-10-15 Order sheets: charging board parts bought with the rest, no longer marked provisional
2026-10-15 Order sheets: out-of-stock and obsolete charging board parts replaced with in-stock ones, TPS259474L eFuse in place of the LM73100
2026-10-15 Charging board page: TPS259474L eFuse wiring and the in-stock part replacements
2026-10-16 Battery price filled in: OVONIC 2S 1100 mAh pair, $26.99
2026-10-16 Motors: Pyrodrone teal/pink listing, the gold/orange one is sold out
2026-10-16 PCB: copper 0.4 mm from the board edge and planes 0.5 mm from the mounting holes, for OSH Park's 4-layer limits
2026-10-16 C33 marked not fitted, and no stencil paste on the empty footprints C14, C15, L3 and C33
2026-10-16 C40, 10 µF on the bottom at a +3V3 plane via 6 mm from the radio supply pins
2026-10-16 Gyro: ground via taken out of pad 7; pads 6 and 7 reach ground through pad 10 (reserved, may be grounded) and pad 11
2026-10-16 D5 pads trimmed to 1.2 mm and the diode moved up 0.1 mm, so its battery pad clears the ESC connector's motor pin by 0.54 mm instead of 0.19
2026-10-16 Plot settings: silkscreen clipped at pad openings, no drill marks
2026-10-16 Docs corrected after the pre-order review: holes and hardware, pin map, battery sense pin, USB socket part, gyro pins, charging board wiring, cable colours
2026-10-16 Rev A order files regenerated after the pre-order review: gerbers, stencil, board copy, schematic PDF, assembly pictures
2026-10-16 Board pictures re-rendered after the pre-order review
2026-10-17 Vias moved out of six small capacitor pads (C4, C6, C22, C23, C25, C26) so they cannot drain the solder
2026-10-17 Five more ground vias in the ESP32's exposed pad, nine in all as Espressif recommends
2026-10-17 Top-side ground pour, with ground vias to keep its islands and blocked-spoke pads left on their own tracks
2026-10-17 Ground stitching vias along both RF traces
2026-10-17 U5 pads lengthened 0.2 mm outward towards TI's DBV land pattern; unused pad 4 left as it was
2026-10-17 Decision log and test plan: second round of pre-order board changes, and what is still left
2026-10-17 Power budget: the top layer now has a ground pour
2026-10-17 Order notes: check and touch up the six joints that still have a via in the pad
2026-10-17 Parts list: the GPS antenna may be discontinued, with the Taoglas patch as the fallback
2026-10-17 Rev A order files regenerated after the second round: gerbers, stencil, board copy, assembly pictures
2026-10-17 Board pictures re-rendered after the second round
2026-10-18 Reroute the +3V3_SENS track by U7
2026-10-18 Test pad labels on the bottom silkscreen, and a GND test pad (TP14)
2026-10-18 Rev A gerbers, board copy and bottom assembly map regenerated with the test pad labels
2026-10-18 Docs: test pad labels and the TP14 ground pad
2026-10-18 Bottom board picture re-rendered with the test pad labels
2026-10-23 Current check: vias now reach the inner planes, and the 3.3 V rail is checked
2026-10-23 ESP32 centre pad: paste openings moved off the nine ground vias
2026-10-24 Rev A gerbers, stencil and board copy regenerated with the new centre-pad paste openings
2026-10-25 J6: use the VoCore2's UART1 (pins 147 and 148), with its real supply range
2026-10-25 Tasks: new owners after the rev A order, mapping drone and ground station plans
2026-10-25 Tasks: ground station positioning plan (F9P base, station M10, TF-Luna docking target)
2026-10-25 Tasks: ground station power for four docks, laptop link and battery plan
2026-10-25 Tasks: ground station split into a power and dock board (Rishab) and a main board (Pranav)
2026-10-29 Ground station: schematic generator, checks, and symbols for the dock eFuse and the VoCore2
2026-10-29 Ground station power and dock board schematic
2026-10-29 Ground station main board schematic
2026-10-29 Docs: ground station boards, and the schematic tasks ticked
2026-10-29 Tasks: Pranav takes the ground station power and dock board, Rishab the main board
